BXSYGJ/PaceRV/materials/README.md

# 竞赛作品材料

- `PaceRV_作品技术报告.pdf`：完整作品技术报告，21 页。
- `PaceRV_嵌赛FPGA_三分钟讲解.pptx`：15 页讲解 PPT。
- `PaceRV_三分钟逐页讲解稿.md`：逐页口播与排练安排。
- `PaceRV_作品海报.pdf`：A1 作品海报。
- `PaceRV_作品海报_高清.png`：10,000 × 14,158 像素高清海报。
- `editable/`：Word 报告与可编辑 SVG 海报。

所有材料使用盘古 100Pro+ 板卡表述。工程源码和烧录说明分别见 `../hardware/` 与 `../hardware/docs/BUILD_AND_RUN.md`。大幅面海报可直接下载；GitHub 在线预览使用首页的小尺寸版本。
