BXSYGJ/PaceRV/materials/PaceRV_三分钟逐页讲解稿.md

# PaceRV 三分钟逐页讲解稿

对应当前 15 页 PPT。排练预算为 180 秒，其中第 14 页包含 12 秒实景片段，口播预算合计 168 秒。时间是剪辑与排练分配，实际时长以录音为准。

每页的正文可以直接朗读；“讲法”用于排练，不进入口播。性能精确值留在画面上，口播按稿内精度表达。

## 第 1 页｜PaceRV · 作品开场｜00:00–00:07

这是 PaceRV：执行效率达到同类 SOTA 水平的五级自研软核。

讲法：PaceRV 后稍停；重读“同类 SOTA 水平”。首页不念性能数字。

## 第 2 页｜赛题成果｜00:07–00:17

我们从完整指令集、五级流水线做到缓存、预测与中断，再拓展音频智能计算，把基础内核做成可集成的计算平台。

讲法：前半句随左右两栏扫过，落点放在“可集成的计算平台”。

## 第 3 页｜国际学术交流｜00:17–00:24

PaceRV 的架构研究已获 IEEE MCSoC 正式论文录用，走向国际学术交流平台。

讲法：会议名称读清楚，不朗读会议截图中的长段介绍。

## 第 4 页｜论文成果｜00:24–00:38

论文抓住了一个关键问题：存储请求何时被接纳，会怎样改变预备乘法结果的保留需求？我们把流水线优化，推进到可量化、可预测的架构研究，全文已公开于 arXiv。

讲法：问题句后稍停；重读“可量化、可预测”。网址留在画面上。

## 第 5 页｜开源成果｜00:38–00:46

源码、构建工程和测试证据已经开源。PaceRV 既能复现，也能成为下一项设计的起点。

讲法：两句之间稍停，GitHub 地址让观众看，不逐字符读。

## 第 6 页｜系统架构｜00:46–00:59

系统由自研处理器调度，音频特征和神经网络交给专用硬件计算。从采集、特征提取到八类结果显示，控制与计算各司其职。

讲法：顺着图从左向右讲，最后回到处理器与专用计算的分工。

## 第 7 页｜CPU 协同优化｜00:59–01:19

我们的优化抓住三个动作：供给不断流，访存早接纳，结果少重算。压缩前端与分支预测维持指令供给；提前接纳请求缓解存储争用；预备乘法按指令身份复用结果，把等待转成有效计算。

讲法：三个动作逐个落音，再用图解释。结尾“把等待转成有效计算”放慢。

## 第 8 页｜主力版本 · Original｜01:19–01:33

这些设计落到了真实板卡上。主力版本跑出五百二十二点五三 CoreMark，频率一百五十五点二五兆赫，完整系统约六千 LUT。高吞吐，也有紧凑实现。

讲法：CoreMark、频率、资源三个信息分开落音。522.531 口播保留两位小数，精确值由页面呈现。

## 第 9 页｜同类 SOTA 执行效率 · H3 Base｜01:33–01:44

衡量架构效率，要看每一兆赫完成多少工作。H3 Base 达到三点四四二，比匹配 VexRiscv 高百分之二十五点五。

讲法：先解释每兆赫指标，再念结果。重读“三点四四二”和“百分之二十五点五”。

## 第 10 页｜性能对照｜01:44–01:52

主力版追求总吞吐，H3 Base 追求每兆赫效率。两种优化点，共同体现架构的可调空间。

讲法：表格让观众看；口播解释两版定位，不逐格报数。

## 第 11 页｜裸核与系统集成｜01:52–02:00

完整 CPU 裸核约四千 LUT，保留运算单元、预测器和寄存器堆，让高性能内核更容易集成。

讲法：重读“完整 CPU 裸核”和“约四千 LUT”。不把折算效率说成新一次裸核板测。

## 第 12 页｜音频与特征提取｜02:00–02:15

现在把计算能力用到声音上。真实采集和重采样已经上板。硬件进一步提取六十四频带特征；按仿真周期折算到一百二十五兆赫，单窗口约四十一点二毫秒。

讲法：第一句完成 CPU 到应用的转场。上板采集与仿真折算各自说清，实物图不遮挡。

## 第 13 页｜神经网络加速｜02:15–02:32

四层卷积，复用十六路八位整数乘加阵列，输出八类乐器结果。按同一频率折算，单轮推理约二百四十九毫秒；两轮连续输入，各层结果均与定点参考逐值一致。

讲法：重读“四层复用”和“逐值一致”。同一频率承接上一页的 125 MHz，画面保留 249.1 ms 精确值。

## 第 14 页｜中文可视化与实景片段｜02:32–02:52

输入波形、梅尔频谱、八类结果，同屏呈现。接下来，请看实物连接与实屏回放。

讲法：约 8 秒口播后留 12 秒实景：整体连接、主板与音频模块、中文实屏回放。保留画面中的回放标识。

## 第 15 页｜PaceRV · 自主计算｜02:52–03:00

从自主内核到专用计算，从论文录用到代码开源。PaceRV，让国产 FPGA 听见更多。

讲法：PaceRV 前稍停，最后一句放慢收住。

## 录制要点

把它当成向评委介绍一件做成的作品。开头落稳，架构页顺图解释，性能页在数字后稍停。重音放在成果、动作和结果上。

SOTA 可读作“搜塔”；CoreMark、LUT、MCSoC、VexRiscv 等名称在录制前统一读法，英文名称也要计入实际口播时间。RV32IMC 和网页地址可由画面承载。

先连贯录一遍，再按实录时长调整各页停留。第 7 页留给机制解释，第 8、9 页留给性能数字。第 3、5、10 页保持简洁。第 14 页为 8 秒讲解和 12 秒实景，实景结束后进入收尾。

这份稿件重新分配了逐页时间，PPT 页面内容保持原样。剪辑按本稿时间表安排。

## 本次写法参考

- [昆士兰大学 3MT 参赛指南](https://threeminutethesis.uq.edu.au/resources/3mt-competitor-guide)：面向听众，用起承转合串起问题、结果与意义，并通过朗读修改。
- [昆士兰大学 3MT 评审标准](https://threeminutethesis.uq.edu.au/resources/judging-criteria-and-panel)：让听众理解动机、设计和结果，图像服务表达。
- [TEDx 演讲准备指南](https://www.ted.com/tedx/organizer-guide/prepare-speakers-and-program)：围绕一个主张安排结构，控制长度，采用自然交谈语气，并反复排练。

以上用于借鉴短讲写法；本视频沿用已有 15 页结构。
