BXSYGJ/PaceRV/materials/photos/100ProPlus开发板.png

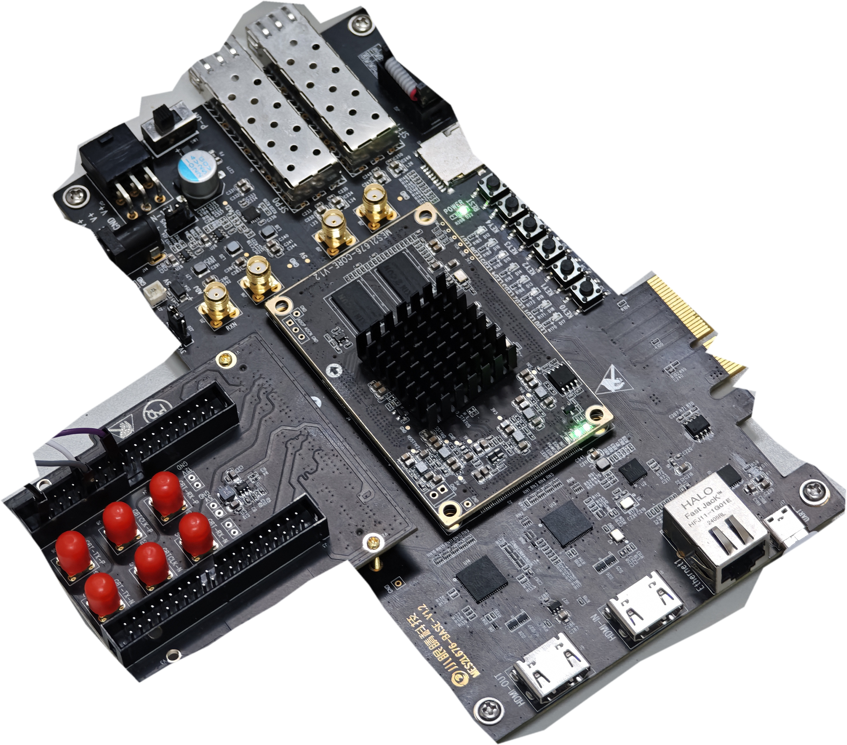
materials/photos/100ProPlus开发板.png
