BXSYGJ/PaceRV/materials/photos/完整系统.jpg

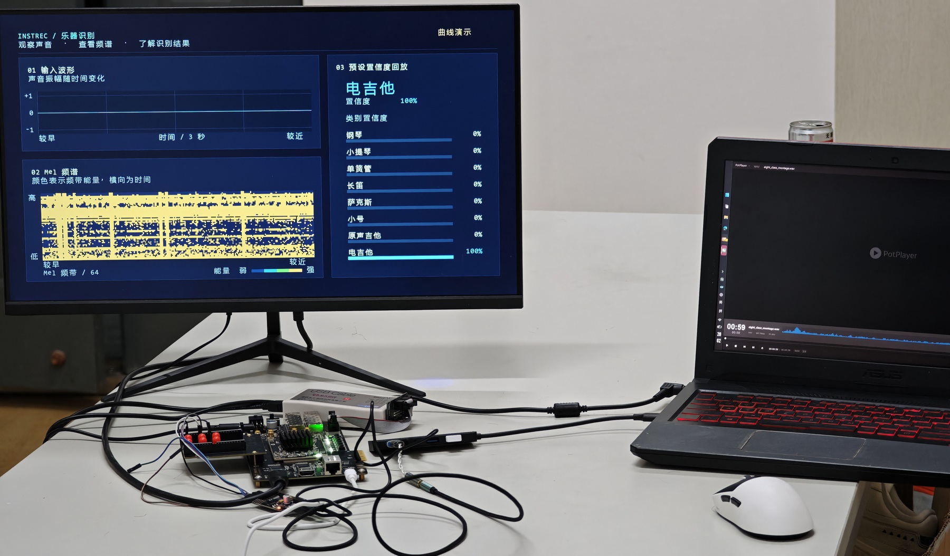
materials/photos/完整系统.jpg
