BXSYGJ/PaceRV/materials/waveforms/H3_Base_145125/analysis/core_bench_matrix/trigger-zoom.png

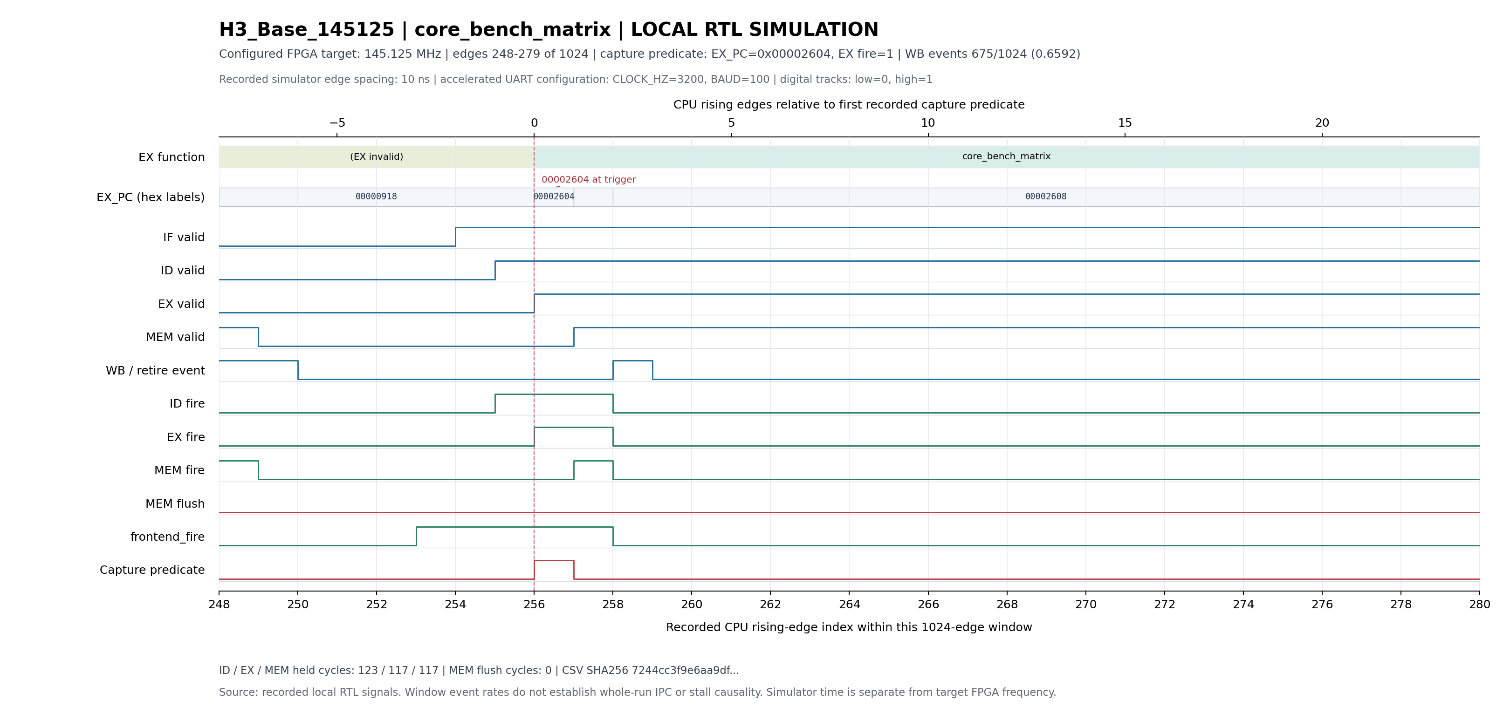
materials/waveforms/H3_Base_145125/analysis/core_bench_matrix/trigger-zoom.png
