BXSYGJ/PaceRV/materials/waveforms/H3_Base_145125/analysis/core_bench_state/full1024.png

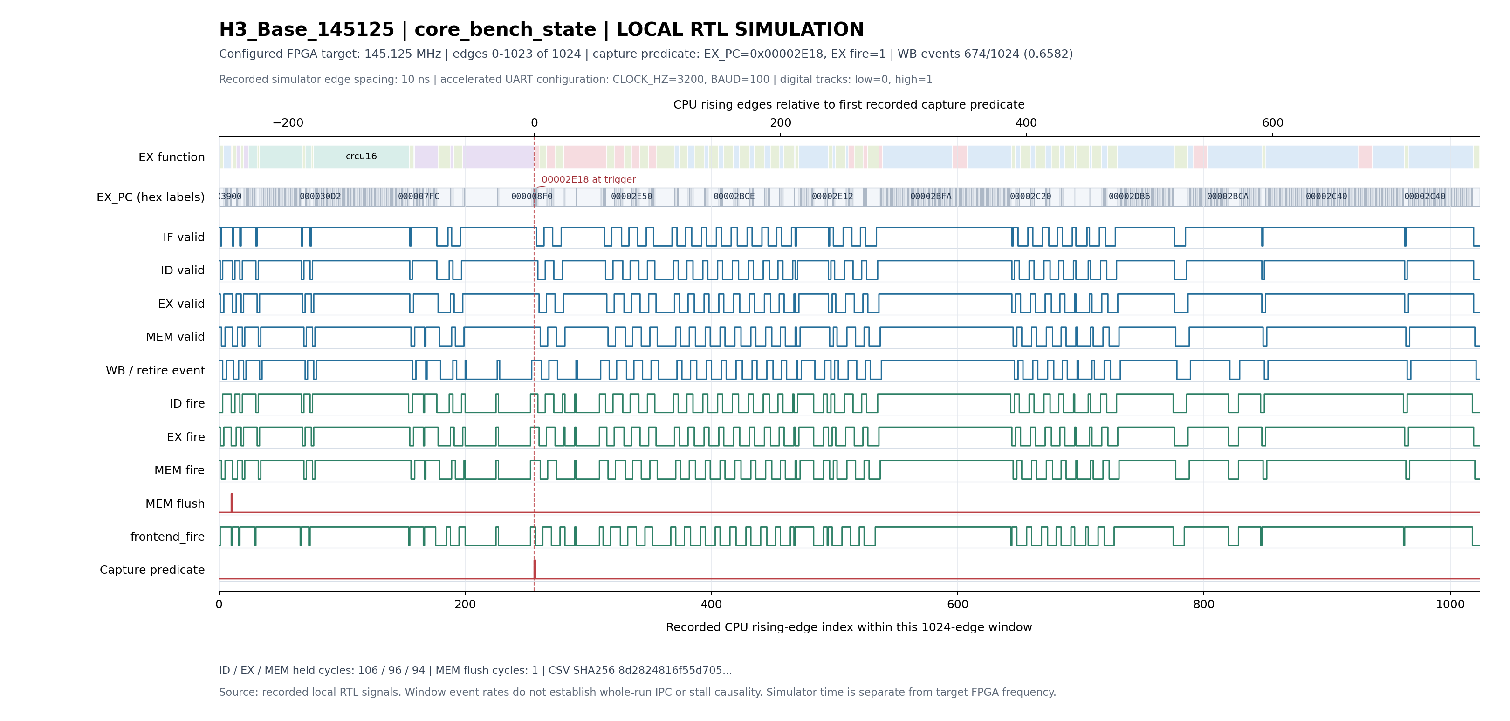
materials/waveforms/H3_Base_145125/analysis/core_bench_state/full1024.png
