BXSYGJ/PaceRV/materials/waveforms/H3_Base_145125/analysis/core_bench_state/trigger-zoom.png

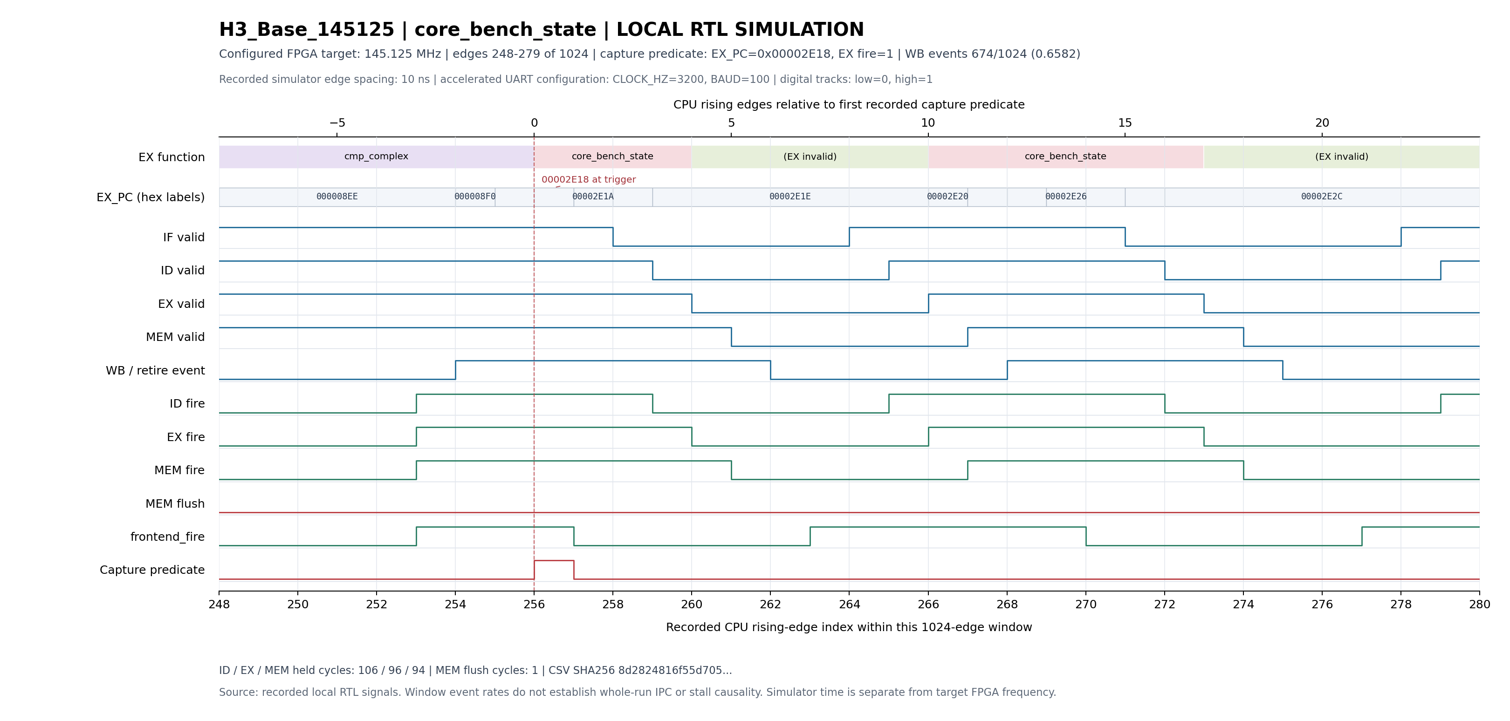
materials/waveforms/H3_Base_145125/analysis/core_bench_state/trigger-zoom.png
