BXSYGJ/PaceRV/materials/waveforms/Original_155250/analysis/core_bench_list/trigger-zoom.png

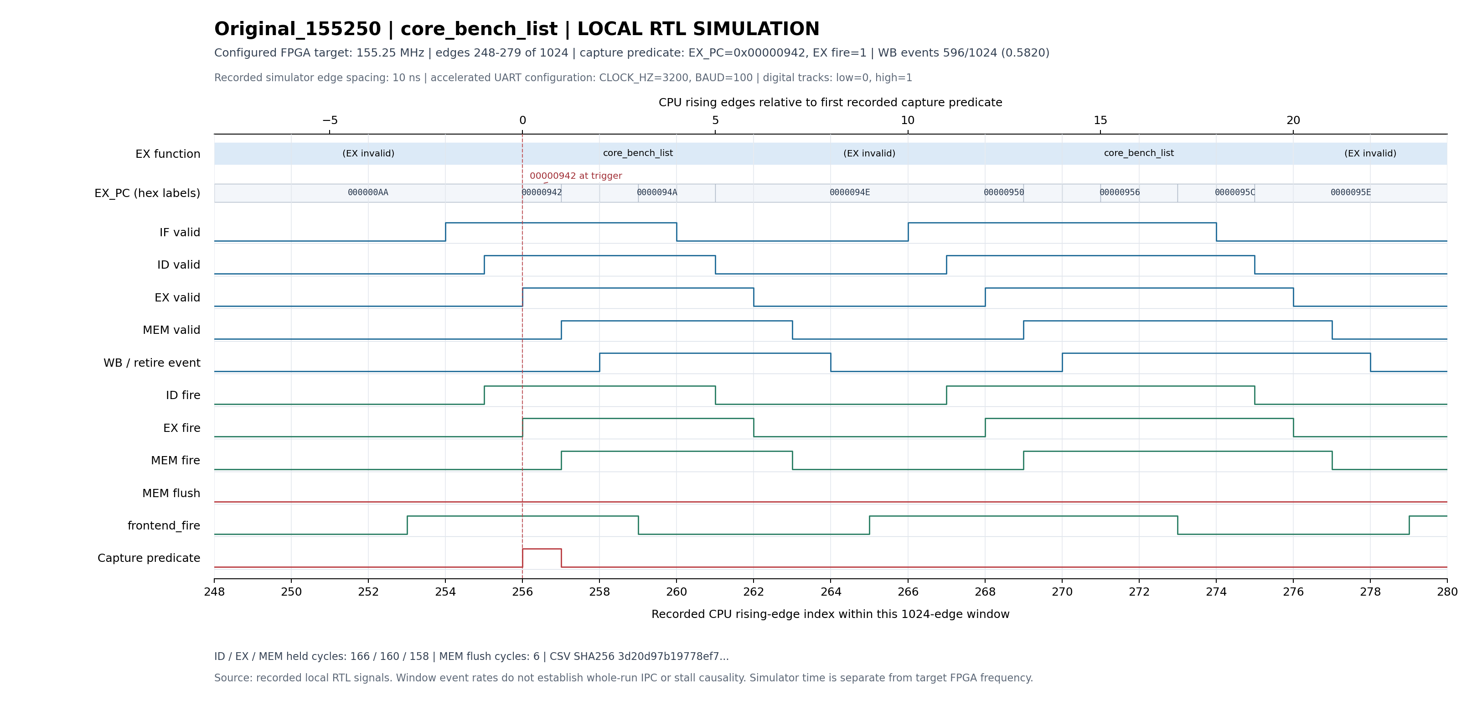
materials/waveforms/Original_155250/analysis/core_bench_list/trigger-zoom.png
