BXSYGJ/PaceRV/materials/waveforms/Original_155250/analysis/core_bench_matrix/full1024.png

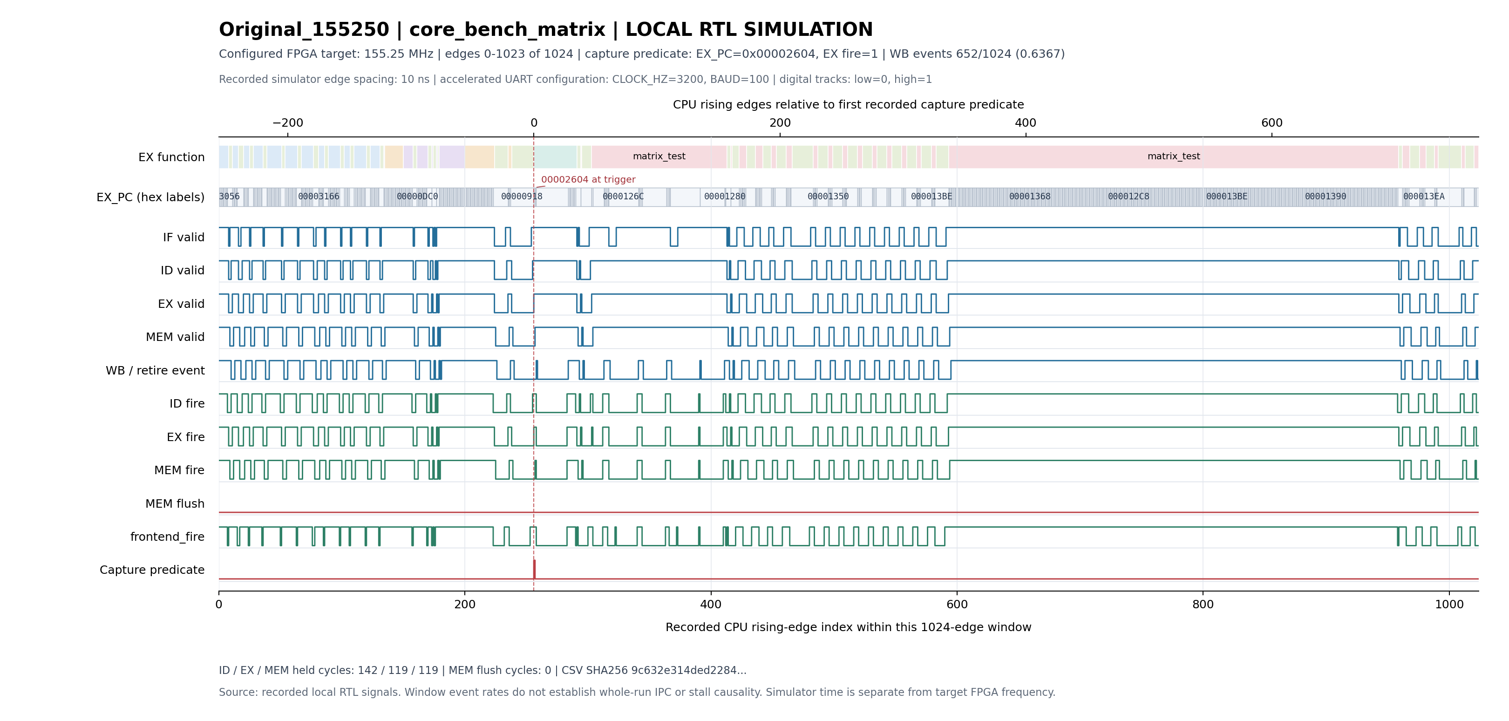
materials/waveforms/Original_155250/analysis/core_bench_matrix/full1024.png
