BXSYGJ/PaceRV/materials/waveforms/Original_155250/analysis/core_bench_state/trigger-zoom.png

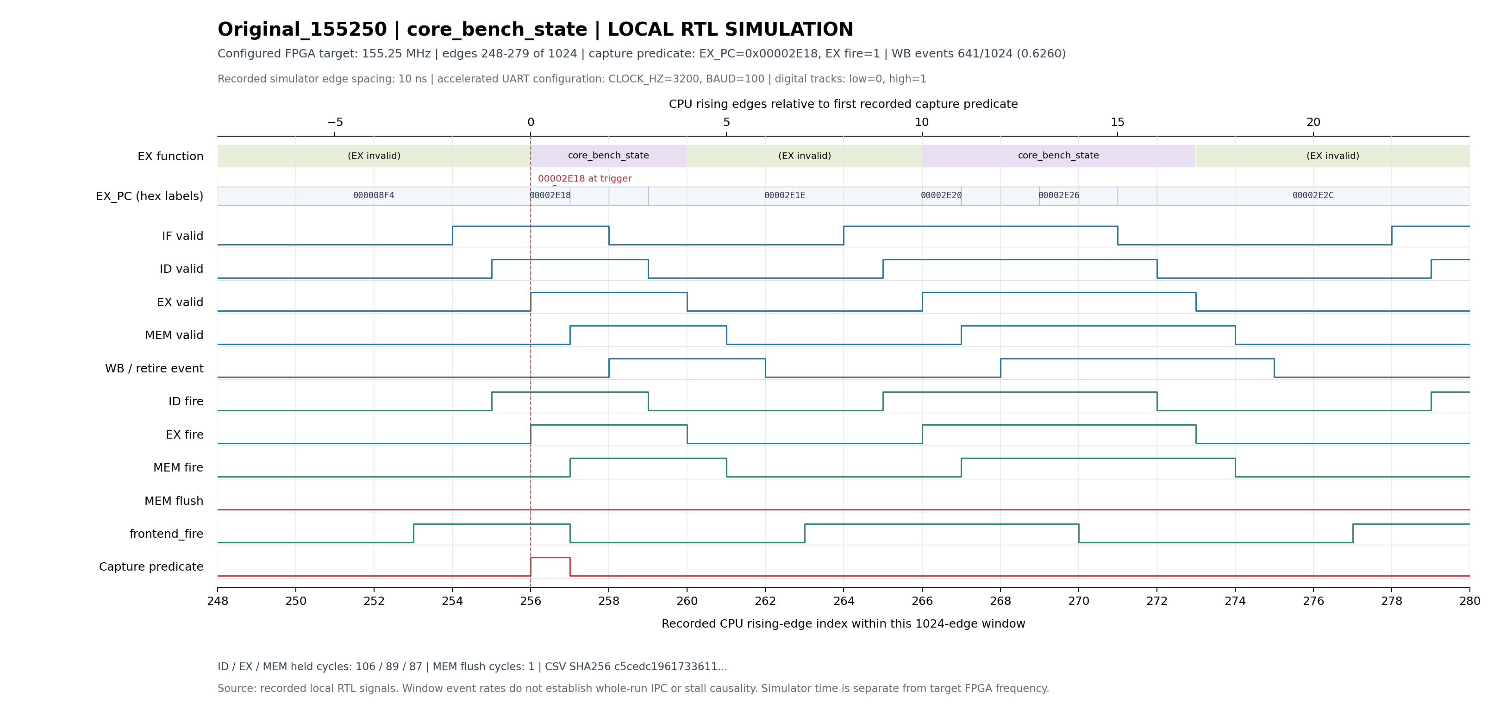
materials/waveforms/Original_155250/analysis/core_bench_state/trigger-zoom.png
