BXSYGJ/PaceRV/materials/PaceRV_作品海报.pdf

## FPGA 创新设计赛道

# PaceRV

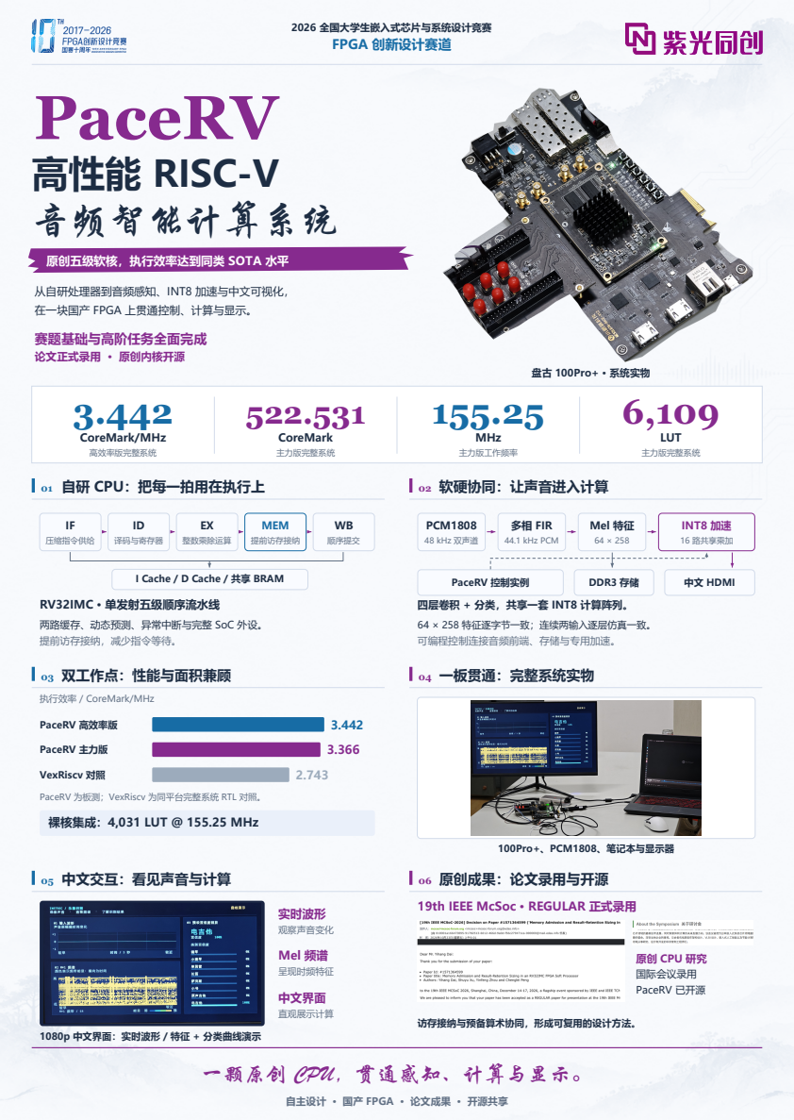
[picture p39: page 1]
2026 全国大学生嵌入式芯片与系统设计竞赛; 高性能 RISC-V 音频智能计算系统; 盘古 100Pro+ · 系统实物; CoreMark/MHz; 高效率版完整系统; CoreMark; 主力版完整系统; MHz; 主力版工作频率; LUT; 01 自研 CPU：把每一拍用在执行上; 02 软硬协同：让声音进入计算; 压缩指令供给; 译码与寄存器; 整数乘除运算; MEM; 提前访存接纳; 顺序提交; PCM1808; 48 kHz 双声道; 多相 FIR; 44.1 kHz PCM; Mel 特征; INT8 加速; 16 路共享乘加; PaceRV 控制实例; DDR3 存储; 中文 HDMI; 03 双工作点：性能与面积兼顾; 04 一板贯通：完整系统实物; PaceRV 高效率版; PaceRV 主力版; VexRiscv 对照; 100Pro+、PCM1808、笔记本与显示器; 05 中文交互：看见声音与计算; 06 原创成果：论文录用与开源; 实时波形; 观察声音变化; Mel 频谱; 呈现时频特征; 中文界面; 直观展示计算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

原创五级软核，执行效率达到同类 SOTA 水平

从自研处理器到音频感知、INT8 加速与中文可视化，
在一块国产 FPGA 上贯通控制、计算与显示。
赛题基础与高阶任务全面完成
论文正式录用 · 原创内核开源

I Cache / D Cache / 共享 BRAM

RV32IMC · 单发射五级顺序流水线
两路缓存、动态预测、异常中断与完整 SoC 外设。
提前访存接纳，减少指令等待。

四层卷积 + 分类，共享一套 INT8 计算阵列。
64 × 258 特征逐字节一致；连续两输入逐层仿真一致。
可编程控制连接音频前端、存储与专用加速。

执行效率 / CoreMark/MHz

PaceRV 为板测；VexRiscv 为同平台完整系统 RTL 对照。

裸核集成：4,031 LUT @ 155.25 MHz

19th IEEE McSoc · REGULAR 正式录用

原创 CPU 研究
国际会议录用
PaceRV 已开源

1080p 中文界面：实时波形 / 特征 + 分类曲线演示

一颗原创 CPU，贯通感知、计算与显示。

自主设计 · 国产 FPGA · 论文成果 · 开源共享
