BXSYGJ/PaceRV/hardware/code/system_application/src/audio/pcm1808_coeff_rom.v

module pcm1808_coeff_rom (
    input wire clk, input wire [7:0] phase, input wire [6:0] tap,
    output wire signed [15:0] coeff
);
    wire mirrored = phase > 8'd73;
    wire [7:0] base_phase = mirrored ? 8'd147 - phase : phase;
    wire [6:0] base_tap = mirrored ? 7'd95 - tap : tap;
    wire [12:0] addr = base_phase * 13'd96 + base_tap;
    reg signed [15:0] base_coeff;
    reg signed [4:0] correction, correction_pipe;
    assign coeff = base_coeff + {{11{correction_pipe[4]}}, correction_pipe};
    always @* begin
        correction = 5'sd0;
        case (phase)
            8'd74: correction = 5'h00;
            8'd75: correction = 5'h19;
            8'd76: correction = 5'h06;
            8'd77: correction = 5'h02;
            8'd78: correction = 5'h1e;
            8'd79: correction = 5'h1f;
            8'd80: correction = 5'h1f;
            8'd81: correction = 5'h03;
            8'd82: correction = 5'h1c;
            8'd83: correction = 5'h04;
            8'd84: correction = 5'h1e;
            8'd85: correction = 5'h1d;
            8'd86: correction = 5'h00;
            8'd87: correction = 5'h1e;
            8'd88: correction = 5'h04;
            8'd89: correction = 5'h00;
            8'd90: correction = 5'h1d;
            8'd91: correction = 5'h02;
            8'd92: correction = 5'h02;
            8'd93: correction = 5'h01;
            8'd94: correction = 5'h06;
            8'd95: correction = 5'h01;
            8'd96: correction = 5'h04;
            8'd97: correction = 5'h1e;
            8'd98: correction = 5'h00;
            8'd99: correction = 5'h04;
            8'd100: correction = 5'h03;
            8'd101: correction = 5'h1f;
            8'd102: correction = 5'h05;
            8'd103: correction = 5'h03;
            8'd104: correction = 5'h02;
            8'd105: correction = 5'h1a;
            8'd106: correction = 5'h01;
            8'd107: correction = 5'h04;
            8'd108: correction = 5'h1f;
            8'd109: correction = 5'h1f;
            8'd110: correction = 5'h1d;
            8'd111: correction = 5'h00;
            8'd112: correction = 5'h1f;
            8'd113: correction = 5'h04;
            8'd114: correction = 5'h03;
            8'd115: correction = 5'h02;
            8'd116: correction = 5'h01;
            8'd117: correction = 5'h01;
            8'd118: correction = 5'h1f;
            8'd119: correction = 5'h1f;
            8'd120: correction = 5'h00;
            8'd121: correction = 5'h1e;
            8'd122: correction = 5'h00;
            8'd123: correction = 5'h1e;
            8'd124: correction = 5'h1d;
            8'd125: correction = 5'h00;
            8'd126: correction = 5'h1f;
            8'd127: correction = 5'h1c;
            8'd128: correction = 5'h1e;
            8'd129: correction = 5'h1d;
            8'd130: correction = 5'h1f;
            8'd131: correction = 5'h1f;
            8'd132: correction = 5'h03;
            8'd133: correction = 5'h1e;
            8'd134: correction = 5'h1e;
            8'd135: correction = 5'h1b;
            8'd136: correction = 5'h02;
            8'd137: correction = 5'h1c;
            8'd138: correction = 5'h01;
            8'd139: correction = 5'h1f;
            8'd140: correction = 5'h03;
            8'd141: correction = 5'h02;
            8'd142: correction = 5'h04;
            8'd143: correction = 5'h01;
            8'd144: correction = 5'h02;
            8'd145: correction = 5'h1c;
            8'd146: correction = 5'h01;
            default: correction = 5'sd0;
        endcase
    end
    always @(posedge clk) begin
        if (mirrored && tap == 7'd47) correction_pipe <= correction;
        else if (mirrored && tap == 7'd48) correction_pipe <= -correction;
        else correction_pipe <= 5'sd0;
        case (addr)
            13'd0: base_coeff <= 16'h0001;
            13'd1: base_coeff <= 16'hfffe;
            13'd2: base_coeff <= 16'h0003;
            13'd3: base_coeff <= 16'hfffc;
            13'd4: base_coeff <= 16'h0004;
            13'd5: base_coeff <= 16'hfffd;
            13'd6: base_coeff <= 16'hffff;
            13'd7: base_coeff <= 16'h0006;
            13'd8: base_coeff <= 16'hfff3;
            13'd9: base_coeff <= 16'h0013;
            13'd10: base_coeff <= 16'hffea;
            13'd11: base_coeff <= 16'h0014;
            13'd12: base_coeff <= 16'hfff5;
            13'd13: base_coeff <= 16'hfffb;
            13'd14: base_coeff <= 16'h001b;
            13'd15: base_coeff <= 16'hffcf;
            13'd16: base_coeff <= 16'h0042;
            13'd17: base_coeff <= 16'hffb9;
            13'd18: base_coeff <= 16'h003a;
            13'd19: base_coeff <= 16'hffe6;
            13'd20: base_coeff <= 16'hffe9;
            13'd21: base_coeff <= 16'h0051;
            13'd22: base_coeff <= 16'hff78;
            13'd23: base_coeff <= 16'h00ac;
            13'd24: base_coeff <= 16'hff52;
            13'd25: base_coeff <= 16'h0085;
            13'd26: base_coeff <= 16'hffd0;
            13'd27: base_coeff <= 16'hffb8;
            13'd28: base_coeff <= 16'h00cd;
            13'd29: base_coeff <= 16'hfebe;
            13'd30: base_coeff <= 16'h0186;
            13'd31: base_coeff <= 16'hfe85;
            13'd32: base_coeff <= 16'h0111;
            13'd33: base_coeff <= 16'hffb8;
            13'd34: base_coeff <= 16'hff39;
            13'd35: base_coeff <= 16'h01ed;
            13'd36: base_coeff <= 16'hfd16;
            13'd37: base_coeff <= 16'h0377;
            13'd38: base_coeff <= 16'hfcad;
            13'd39: base_coeff <= 16'h024f;
            13'd40: base_coeff <= 16'hffa6;
            13'd41: base_coeff <= 16'hfd8a;
            13'd42: base_coeff <= 16'h05e6;
            13'd43: base_coeff <= 16'hf666;
            13'd44: base_coeff <= 16'h0d24;
            13'd45: base_coeff <= 16'heff0;
            13'd46: base_coeff <= 16'h11fe;
            13'd47: base_coeff <= 16'h6d54;
            13'd48: base_coeff <= 16'h11fe;
            13'd49: base_coeff <= 16'heff0;
            13'd50: base_coeff <= 16'h0d24;
            13'd51: base_coeff <= 16'hf666;
            13'd52: base_coeff <= 16'h05e6;
            13'd53: base_coeff <= 16'hfd8a;
            13'd54: base_coeff <= 16'hffa6;
            13'd55: base_coeff <= 16'h024f;
            13'd56: base_coeff <= 16'hfcad;
            13'd57: base_coeff <= 16'h0377;
            13'd58: base_coeff <= 16'hfd16;
            13'd59: base_coeff <= 16'h01ed;
            13'd60: base_coeff <= 16'hff39;
            13'd61: base_coeff <= 16'hffb8;
            13'd62: base_coeff <= 16'h0111;
            13'd63: base_coeff <= 16'hfe85;
            13'd64: base_coeff <= 16'h0186;
            13'd65: base_coeff <= 16'hfebe;
            13'd66: base_coeff <= 16'h00cd;
            13'd67: base_coeff <= 16'hffb8;
            13'd68: base_coeff <= 16'hffd0;
            13'd69: base_coeff <= 16'h0085;
            13'd70: base_coeff <= 16'hff52;
            13'd71: base_coeff <= 16'h00ac;
            13'd72: base_coeff <= 16'hff78;
            13'd73: base_coeff <= 16'h0051;
            13'd74: base_coeff <= 16'hffe9;
            13'd75: base_coeff <= 16'hffe6;
            13'd76: base_coeff <= 16'h003a;
            13'd77: base_coeff <= 16'hffb9;
            13'd78: base_coeff <= 16'h0042;
            13'd79: base_coeff <= 16'hffcf;
            13'd80: base_coeff <= 16'h001b;
            13'd81: base_coeff <= 16'hfffb;
            13'd82: base_coeff <= 16'hfff5;
            13'd83: base_coeff <= 16'h0014;
            13'd84: base_coeff <= 16'hffea;
            13'd85: base_coeff <= 16'h0013;
            13'd86: base_coeff <= 16'hfff3;
            13'd87: base_coeff <= 16'h0006;
            13'd88: base_coeff <= 16'hffff;
            13'd89: base_coeff <= 16'hfffd;
            13'd90: base_coeff <= 16'h0004;
            13'd91: base_coeff <= 16'hfffc;
            13'd92: base_coeff <= 16'h0003;
            13'd93: base_coeff <= 16'hfffe;
            13'd94: base_coeff <= 16'h0001;
            13'd95: base_coeff <= 16'h0000;
            13'd96: base_coeff <= 16'h0001;
            13'd97: base_coeff <= 16'hfffe;
            13'd98: base_coeff <= 16'h0003;
            13'd99: base_coeff <= 16'hfffc;
            13'd100: base_coeff <= 16'h0004;
            13'd101: base_coeff <= 16'hfffd;
            13'd102: base_coeff <= 16'hffff;
            13'd103: base_coeff <= 16'h0006;
            13'd104: base_coeff <= 16'hfff3;
            13'd105: base_coeff <= 16'h0013;
            13'd106: base_coeff <= 16'hffea;
            13'd107: base_coeff <= 16'h0014;
            13'd108: base_coeff <= 16'hfff6;
            13'd109: base_coeff <= 16'hfffa;
            13'd110: base_coeff <= 16'h001b;
            13'd111: base_coeff <= 16'hffcf;
            13'd112: base_coeff <= 16'h0042;
            13'd113: base_coeff <= 16'hffba;
            13'd114: base_coeff <= 16'h0039;
            13'd115: base_coeff <= 16'hffe8;
            13'd116: base_coeff <= 16'hffe7;
            13'd117: base_coeff <= 16'h0053;
            13'd118: base_coeff <= 16'hff77;
            13'd119: base_coeff <= 16'h00ab;
            13'd120: base_coeff <= 16'hff54;
            13'd121: base_coeff <= 16'h0082;
            13'd122: base_coeff <= 16'hffd4;
            13'd123: base_coeff <= 16'hffb3;
            13'd124: base_coeff <= 16'h00d1;
            13'd125: base_coeff <= 16'hfebc;
            13'd126: base_coeff <= 16'h0185;
            13'd127: base_coeff <= 16'hfe89;
            13'd128: base_coeff <= 16'h0109;
            13'd129: base_coeff <= 16'hffc2;
            13'd130: base_coeff <= 16'hff2f;
            13'd131: base_coeff <= 16'h01f5;
            13'd132: base_coeff <= 16'hfd12;
            13'd133: base_coeff <= 16'h0374;
            13'd134: base_coeff <= 16'hfcb8;
            13'd135: base_coeff <= 16'h023c;
            13'd136: base_coeff <= 16'hffbf;
            13'd137: base_coeff <= 16'hfd6f;
            13'd138: base_coeff <= 16'h05fc;
            13'd139: base_coeff <= 16'hf65e;
            13'd140: base_coeff <= 16'h0d0f;
            13'd141: base_coeff <= 16'hf038;
            13'd142: base_coeff <= 16'h1135;
            13'd143: base_coeff <= 16'h6d55;
            13'd144: base_coeff <= 16'h12c9;
            13'd145: base_coeff <= 16'hefa8;
            13'd146: base_coeff <= 16'h0d37;
            13'd147: base_coeff <= 16'hf66e;
            13'd148: base_coeff <= 16'h05d0;
            13'd149: base_coeff <= 16'hfda5;
            13'd150: base_coeff <= 16'hff8c;
            13'd151: base_coeff <= 16'h0263;
            13'd152: base_coeff <= 16'hfca1;
            13'd153: base_coeff <= 16'h037a;
            13'd154: base_coeff <= 16'hfd1a;
            13'd155: base_coeff <= 16'h01e4;
            13'd156: base_coeff <= 16'hff44;
            13'd157: base_coeff <= 16'hffae;
            13'd158: base_coeff <= 16'h0118;
            13'd159: base_coeff <= 16'hfe81;
            13'd160: base_coeff <= 16'h0187;
            13'd161: base_coeff <= 16'hfec0;
            13'd162: base_coeff <= 16'h00c9;
            13'd163: base_coeff <= 16'hffbd;
            13'd164: base_coeff <= 16'hffcb;
            13'd165: base_coeff <= 16'h0089;
            13'd166: base_coeff <= 16'hff50;
            13'd167: base_coeff <= 16'h00ac;
            13'd168: base_coeff <= 16'hff7a;
            13'd169: base_coeff <= 16'h004f;
            13'd170: base_coeff <= 16'hffeb;
            13'd171: base_coeff <= 16'hffe4;
            13'd172: base_coeff <= 16'h003b;
            13'd173: base_coeff <= 16'hffb9;
            13'd174: base_coeff <= 16'h0042;
            13'd175: base_coeff <= 16'hffd0;
            13'd176: base_coeff <= 16'h001a;
            13'd177: base_coeff <= 16'hfffb;
            13'd178: base_coeff <= 16'hfff4;
            13'd179: base_coeff <= 16'h0014;
            13'd180: base_coeff <= 16'hffea;
            13'd181: base_coeff <= 16'h0013;
            13'd182: base_coeff <= 16'hfff3;
            13'd183: base_coeff <= 16'h0006;
            13'd184: base_coeff <= 16'h0000;
            13'd185: base_coeff <= 16'hfffd;
            13'd186: base_coeff <= 16'h0004;
            13'd187: base_coeff <= 16'hfffc;
            13'd188: base_coeff <= 16'h0003;
            13'd189: base_coeff <= 16'hfffe;
            13'd190: base_coeff <= 16'h0001;
            13'd191: base_coeff <= 16'h0000;
            13'd192: base_coeff <= 16'h0001;
            13'd193: base_coeff <= 16'hfffe;
            13'd194: base_coeff <= 16'h0003;
            13'd195: base_coeff <= 16'hfffc;
            13'd196: base_coeff <= 16'h0004;
            13'd197: base_coeff <= 16'hfffd;
            13'd198: base_coeff <= 16'hffff;
            13'd199: base_coeff <= 16'h0007;
            13'd200: base_coeff <= 16'hfff3;
            13'd201: base_coeff <= 16'h0013;
            13'd202: base_coeff <= 16'hffea;
            13'd203: base_coeff <= 16'h0013;
            13'd204: base_coeff <= 16'hfff6;
            13'd205: base_coeff <= 16'hfff9;
            13'd206: base_coeff <= 16'h001c;
            13'd207: base_coeff <= 16'hffce;
            13'd208: base_coeff <= 16'h0042;
            13'd209: base_coeff <= 16'hffbb;
            13'd210: base_coeff <= 16'h0038;
            13'd211: base_coeff <= 16'hffe9;
            13'd212: base_coeff <= 16'hffe5;
            13'd213: base_coeff <= 16'h0055;
            13'd214: base_coeff <= 16'hff76;
            13'd215: base_coeff <= 16'h00ab;
            13'd216: base_coeff <= 16'hff56;
            13'd217: base_coeff <= 16'h007f;
            13'd218: base_coeff <= 16'hffd9;
            13'd219: base_coeff <= 16'hffaf;
            13'd220: base_coeff <= 16'h00d5;
            13'd221: base_coeff <= 16'hfeba;
            13'd222: base_coeff <= 16'h0184;
            13'd223: base_coeff <= 16'hfe8e;
            13'd224: base_coeff <= 16'h0101;
            13'd225: base_coeff <= 16'hffcc;
            13'd226: base_coeff <= 16'hff24;
            13'd227: base_coeff <= 16'h01fd;
            13'd228: base_coeff <= 16'hfd0f;
            13'd229: base_coeff <= 16'h0371;
            13'd230: base_coeff <= 16'hfcc3;
            13'd231: base_coeff <= 16'h0228;
            13'd232: base_coeff <= 16'hffd8;
            13'd233: base_coeff <= 16'hfd55;
            13'd234: base_coeff <= 16'h0611;
            13'd235: base_coeff <= 16'hf658;
            13'd236: base_coeff <= 16'h0cfa;
            13'd237: base_coeff <= 16'hf081;
            13'd238: base_coeff <= 16'h106d;
            13'd239: base_coeff <= 16'h6d4b;
            13'd240: base_coeff <= 16'h1394;
            13'd241: base_coeff <= 16'hef62;
            13'd242: base_coeff <= 16'h0d4a;
            13'd243: base_coeff <= 16'hf677;
            13'd244: base_coeff <= 16'h05b9;
            13'd245: base_coeff <= 16'hfdc1;
            13'd246: base_coeff <= 16'hff73;
            13'd247: base_coeff <= 16'h0276;
            13'd248: base_coeff <= 16'hfc97;
            13'd249: base_coeff <= 16'h037d;
            13'd250: base_coeff <= 16'hfd1f;
            13'd251: base_coeff <= 16'h01db;
            13'd252: base_coeff <= 16'hff4e;
            13'd253: base_coeff <= 16'hffa4;
            13'd254: base_coeff <= 16'h0120;
            13'd255: base_coeff <= 16'hfe7d;
            13'd256: base_coeff <= 16'h0187;
            13'd257: base_coeff <= 16'hfec2;
            13'd258: base_coeff <= 16'h00c5;
            13'd259: base_coeff <= 16'hffc2;
            13'd260: base_coeff <= 16'hffc7;
            13'd261: base_coeff <= 16'h008c;
            13'd262: base_coeff <= 16'hff4f;
            13'd263: base_coeff <= 16'h00ac;
            13'd264: base_coeff <= 16'hff7b;
            13'd265: base_coeff <= 16'h004d;
            13'd266: base_coeff <= 16'hffed;
            13'd267: base_coeff <= 16'hffe2;
            13'd268: base_coeff <= 16'h003d;
            13'd269: base_coeff <= 16'hffb8;
            13'd270: base_coeff <= 16'h0042;
            13'd271: base_coeff <= 16'hffd0;
            13'd272: base_coeff <= 16'h0019;
            13'd273: base_coeff <= 16'hfffc;
            13'd274: base_coeff <= 16'hfff4;
            13'd275: base_coeff <= 16'h0015;
            13'd276: base_coeff <= 16'hffe9;
            13'd277: base_coeff <= 16'h0013;
            13'd278: base_coeff <= 16'hfff3;
            13'd279: base_coeff <= 16'h0006;
            13'd280: base_coeff <= 16'h0000;
            13'd281: base_coeff <= 16'hfffd;
            13'd282: base_coeff <= 16'h0005;
            13'd283: base_coeff <= 16'hfffc;
            13'd284: base_coeff <= 16'h0003;
            13'd285: base_coeff <= 16'hfffe;
            13'd286: base_coeff <= 16'h0001;
            13'd287: base_coeff <= 16'h0000;
            13'd288: base_coeff <= 16'h0001;
            13'd289: base_coeff <= 16'hfffe;
            13'd290: base_coeff <= 16'h0003;
            13'd291: base_coeff <= 16'hfffc;
            13'd292: base_coeff <= 16'h0004;
            13'd293: base_coeff <= 16'hfffd;
            13'd294: base_coeff <= 16'hffff;
            13'd295: base_coeff <= 16'h0007;
            13'd296: base_coeff <= 16'hfff3;
            13'd297: base_coeff <= 16'h0013;
            13'd298: base_coeff <= 16'hffea;
            13'd299: base_coeff <= 16'h0013;
            13'd300: base_coeff <= 16'hfff7;
            13'd301: base_coeff <= 16'hfff9;
            13'd302: base_coeff <= 16'h001d;
            13'd303: base_coeff <= 16'hffce;
            13'd304: base_coeff <= 16'h0042;
            13'd305: base_coeff <= 16'hffbb;
            13'd306: base_coeff <= 16'h0036;
            13'd307: base_coeff <= 16'hffeb;
            13'd308: base_coeff <= 16'hffe3;
            13'd309: base_coeff <= 16'h0056;
            13'd310: base_coeff <= 16'hff75;
            13'd311: base_coeff <= 16'h00ab;
            13'd312: base_coeff <= 16'hff57;
            13'd313: base_coeff <= 16'h007b;
            13'd314: base_coeff <= 16'hffdd;
            13'd315: base_coeff <= 16'hffaa;
            13'd316: base_coeff <= 16'h00d9;
            13'd317: base_coeff <= 16'hfeb8;
            13'd318: base_coeff <= 16'h0183;
            13'd319: base_coeff <= 16'hfe92;
            13'd320: base_coeff <= 16'h00f9;
            13'd321: base_coeff <= 16'hffd6;
            13'd322: base_coeff <= 16'hff1a;
            13'd323: base_coeff <= 16'h0206;
            13'd324: base_coeff <= 16'hfd0b;
            13'd325: base_coeff <= 16'h036d;
            13'd326: base_coeff <= 16'hfccf;
            13'd327: base_coeff <= 16'h0215;
            13'd328: base_coeff <= 16'hfff1;
            13'd329: base_coeff <= 16'hfd3b;
            13'd330: base_coeff <= 16'h0625;
            13'd331: base_coeff <= 16'hf653;
            13'd332: base_coeff <= 16'h0ce3;
            13'd333: base_coeff <= 16'hf0cb;
            13'd334: base_coeff <= 16'h0fa6;
            13'd335: base_coeff <= 16'h6d49;
            13'd336: base_coeff <= 16'h1461;
            13'd337: base_coeff <= 16'hef1c;
            13'd338: base_coeff <= 16'h0d5b;
            13'd339: base_coeff <= 16'hf680;
            13'd340: base_coeff <= 16'h05a2;
            13'd341: base_coeff <= 16'hfddc;
            13'd342: base_coeff <= 16'hff5a;
            13'd343: base_coeff <= 16'h0288;
            13'd344: base_coeff <= 16'hfc8c;
            13'd345: base_coeff <= 16'h037f;
            13'd346: base_coeff <= 16'hfd23;
            13'd347: base_coeff <= 16'h01d2;
            13'd348: base_coeff <= 16'hff59;
            13'd349: base_coeff <= 16'hff9a;
            13'd350: base_coeff <= 16'h0127;
            13'd351: base_coeff <= 16'hfe79;
            13'd352: base_coeff <= 16'h0188;
            13'd353: base_coeff <= 16'hfec5;
            13'd354: base_coeff <= 16'h00c0;
            13'd355: base_coeff <= 16'hffc7;
            13'd356: base_coeff <= 16'hffc3;
            13'd357: base_coeff <= 16'h008f;
            13'd358: base_coeff <= 16'hff4d;
            13'd359: base_coeff <= 16'h00ac;
            13'd360: base_coeff <= 16'hff7c;
            13'd361: base_coeff <= 16'h004b;
            13'd362: base_coeff <= 16'hfff0;
            13'd363: base_coeff <= 16'hffe0;
            13'd364: base_coeff <= 16'h003e;
            13'd365: base_coeff <= 16'hffb8;
            13'd366: base_coeff <= 16'h0041;
            13'd367: base_coeff <= 16'hffd1;
            13'd368: base_coeff <= 16'h0018;
            13'd369: base_coeff <= 16'hfffd;
            13'd370: base_coeff <= 16'hfff3;
            13'd371: base_coeff <= 16'h0015;
            13'd372: base_coeff <= 16'hffe9;
            13'd373: base_coeff <= 16'h0013;
            13'd374: base_coeff <= 16'hfff3;
            13'd375: base_coeff <= 16'h0006;
            13'd376: base_coeff <= 16'h0000;
            13'd377: base_coeff <= 16'hfffd;
            13'd378: base_coeff <= 16'h0005;
            13'd379: base_coeff <= 16'hfffc;
            13'd380: base_coeff <= 16'h0003;
            13'd381: base_coeff <= 16'hfffe;
            13'd382: base_coeff <= 16'h0001;
            13'd383: base_coeff <= 16'h0000;
            13'd384: base_coeff <= 16'h0001;
            13'd385: base_coeff <= 16'hfffe;
            13'd386: base_coeff <= 16'h0003;
            13'd387: base_coeff <= 16'hfffc;
            13'd388: base_coeff <= 16'h0004;
            13'd389: base_coeff <= 16'hfffe;
            13'd390: base_coeff <= 16'hffff;
            13'd391: base_coeff <= 16'h0007;
            13'd392: base_coeff <= 16'hfff3;
            13'd393: base_coeff <= 16'h0013;
            13'd394: base_coeff <= 16'hffea;
            13'd395: base_coeff <= 16'h0012;
            13'd396: base_coeff <= 16'hfff7;
            13'd397: base_coeff <= 16'hfff8;
            13'd398: base_coeff <= 16'h001d;
            13'd399: base_coeff <= 16'hffce;
            13'd400: base_coeff <= 16'h0041;
            13'd401: base_coeff <= 16'hffbc;
            13'd402: base_coeff <= 16'h0035;
            13'd403: base_coeff <= 16'hffed;
            13'd404: base_coeff <= 16'hffe1;
            13'd405: base_coeff <= 16'h0058;
            13'd406: base_coeff <= 16'hff74;
            13'd407: base_coeff <= 16'h00aa;
            13'd408: base_coeff <= 16'hff59;
            13'd409: base_coeff <= 16'h0078;
            13'd410: base_coeff <= 16'hffe2;
            13'd411: base_coeff <= 16'hffa5;
            13'd412: base_coeff <= 16'h00dd;
            13'd413: base_coeff <= 16'hfeb6;
            13'd414: base_coeff <= 16'h0182;
            13'd415: base_coeff <= 16'hfe97;
            13'd416: base_coeff <= 16'h00f1;
            13'd417: base_coeff <= 16'hffe0;
            13'd418: base_coeff <= 16'hff10;
            13'd419: base_coeff <= 16'h020d;
            13'd420: base_coeff <= 16'hfd08;
            13'd421: base_coeff <= 16'h0369;
            13'd422: base_coeff <= 16'hfcdb;
            13'd423: base_coeff <= 16'h0201;
            13'd424: base_coeff <= 16'h000a;
            13'd425: base_coeff <= 16'hfd21;
            13'd426: base_coeff <= 16'h0639;
            13'd427: base_coeff <= 16'hf64e;
            13'd428: base_coeff <= 16'h0ccb;
            13'd429: base_coeff <= 16'hf115;
            13'd430: base_coeff <= 16'h0ee1;
            13'd431: base_coeff <= 16'h6d3d;
            13'd432: base_coeff <= 16'h152f;
            13'd433: base_coeff <= 16'heed8;
            13'd434: base_coeff <= 16'h0d6c;
            13'd435: base_coeff <= 16'hf68b;
            13'd436: base_coeff <= 16'h058a;
            13'd437: base_coeff <= 16'hfdf8;
            13'd438: base_coeff <= 16'hff40;
            13'd439: base_coeff <= 16'h029b;
            13'd440: base_coeff <= 16'hfc82;
            13'd441: base_coeff <= 16'h0381;
            13'd442: base_coeff <= 16'hfd28;
            13'd443: base_coeff <= 16'h01c9;
            13'd444: base_coeff <= 16'hff64;
            13'd445: base_coeff <= 16'hff90;
            13'd446: base_coeff <= 16'h012f;
            13'd447: base_coeff <= 16'hfe75;
            13'd448: base_coeff <= 16'h0188;
            13'd449: base_coeff <= 16'hfec7;
            13'd450: base_coeff <= 16'h00bc;
            13'd451: base_coeff <= 16'hffcc;
            13'd452: base_coeff <= 16'hffbe;
            13'd453: base_coeff <= 16'h0092;
            13'd454: base_coeff <= 16'hff4c;
            13'd455: base_coeff <= 16'h00ac;
            13'd456: base_coeff <= 16'hff7d;
            13'd457: base_coeff <= 16'h0049;
            13'd458: base_coeff <= 16'hfff2;
            13'd459: base_coeff <= 16'hffdf;
            13'd460: base_coeff <= 16'h003f;
            13'd461: base_coeff <= 16'hffb7;
            13'd462: base_coeff <= 16'h0041;
            13'd463: base_coeff <= 16'hffd1;
            13'd464: base_coeff <= 16'h0018;
            13'd465: base_coeff <= 16'hfffe;
            13'd466: base_coeff <= 16'hfff3;
            13'd467: base_coeff <= 16'h0016;
            13'd468: base_coeff <= 16'hffe9;
            13'd469: base_coeff <= 16'h0013;
            13'd470: base_coeff <= 16'hfff4;
            13'd471: base_coeff <= 16'h0005;
            13'd472: base_coeff <= 16'h0000;
            13'd473: base_coeff <= 16'hfffd;
            13'd474: base_coeff <= 16'h0005;
            13'd475: base_coeff <= 16'hfffc;
            13'd476: base_coeff <= 16'h0003;
            13'd477: base_coeff <= 16'hfffe;
            13'd478: base_coeff <= 16'h0001;
            13'd479: base_coeff <= 16'h0000;
            13'd480: base_coeff <= 16'h0001;
            13'd481: base_coeff <= 16'hfffe;
            13'd482: base_coeff <= 16'h0003;
            13'd483: base_coeff <= 16'hfffc;
            13'd484: base_coeff <= 16'h0004;
            13'd485: base_coeff <= 16'hfffe;
            13'd486: base_coeff <= 16'hfffe;
            13'd487: base_coeff <= 16'h0007;
            13'd488: base_coeff <= 16'hfff2;
            13'd489: base_coeff <= 16'h0013;
            13'd490: base_coeff <= 16'hffeb;
            13'd491: base_coeff <= 16'h0012;
            13'd492: base_coeff <= 16'hfff8;
            13'd493: base_coeff <= 16'hfff7;
            13'd494: base_coeff <= 16'h001e;
            13'd495: base_coeff <= 16'hffcd;
            13'd496: base_coeff <= 16'h0041;
            13'd497: base_coeff <= 16'hffbd;
            13'd498: base_coeff <= 16'h0034;
            13'd499: base_coeff <= 16'hffef;
            13'd500: base_coeff <= 16'hffdf;
            13'd501: base_coeff <= 16'h005a;
            13'd502: base_coeff <= 16'hff73;
            13'd503: base_coeff <= 16'h00aa;
            13'd504: base_coeff <= 16'hff5b;
            13'd505: base_coeff <= 16'h0074;
            13'd506: base_coeff <= 16'hffe6;
            13'd507: base_coeff <= 16'hffa1;
            13'd508: base_coeff <= 16'h00e1;
            13'd509: base_coeff <= 16'hfeb4;
            13'd510: base_coeff <= 16'h0180;
            13'd511: base_coeff <= 16'hfe9c;
            13'd512: base_coeff <= 16'h00e9;
            13'd513: base_coeff <= 16'hffea;
            13'd514: base_coeff <= 16'hff06;
            13'd515: base_coeff <= 16'h0215;
            13'd516: base_coeff <= 16'hfd05;
            13'd517: base_coeff <= 16'h0365;
            13'd518: base_coeff <= 16'hfce8;
            13'd519: base_coeff <= 16'h01ed;
            13'd520: base_coeff <= 16'h0024;
            13'd521: base_coeff <= 16'hfd07;
            13'd522: base_coeff <= 16'h064d;
            13'd523: base_coeff <= 16'hf64a;
            13'd524: base_coeff <= 16'h0cb3;
            13'd525: base_coeff <= 16'hf161;
            13'd526: base_coeff <= 16'h0e1c;
            13'd527: base_coeff <= 16'h6d32;
            13'd528: base_coeff <= 16'h15fe;
            13'd529: base_coeff <= 16'hee94;
            13'd530: base_coeff <= 16'h0d7b;
            13'd531: base_coeff <= 16'hf696;
            13'd532: base_coeff <= 16'h0571;
            13'd533: base_coeff <= 16'hfe14;
            13'd534: base_coeff <= 16'hff27;
            13'd535: base_coeff <= 16'h02ae;
            13'd536: base_coeff <= 16'hfc78;
            13'd537: base_coeff <= 16'h0382;
            13'd538: base_coeff <= 16'hfd2d;
            13'd539: base_coeff <= 16'h01bf;
            13'd540: base_coeff <= 16'hff6f;
            13'd541: base_coeff <= 16'hff86;
            13'd542: base_coeff <= 16'h0136;
            13'd543: base_coeff <= 16'hfe71;
            13'd544: base_coeff <= 16'h0188;
            13'd545: base_coeff <= 16'hfeca;
            13'd546: base_coeff <= 16'h00b8;
            13'd547: base_coeff <= 16'hffd1;
            13'd548: base_coeff <= 16'hffba;
            13'd549: base_coeff <= 16'h0095;
            13'd550: base_coeff <= 16'hff4a;
            13'd551: base_coeff <= 16'h00ac;
            13'd552: base_coeff <= 16'hff7e;
            13'd553: base_coeff <= 16'h0047;
            13'd554: base_coeff <= 16'hfff4;
            13'd555: base_coeff <= 16'hffdd;
            13'd556: base_coeff <= 16'h0040;
            13'd557: base_coeff <= 16'hffb7;
            13'd558: base_coeff <= 16'h0041;
            13'd559: base_coeff <= 16'hffd2;
            13'd560: base_coeff <= 16'h0017;
            13'd561: base_coeff <= 16'hfffe;
            13'd562: base_coeff <= 16'hfff2;
            13'd563: base_coeff <= 16'h0016;
            13'd564: base_coeff <= 16'hffe9;
            13'd565: base_coeff <= 16'h0013;
            13'd566: base_coeff <= 16'hfff4;
            13'd567: base_coeff <= 16'h0005;
            13'd568: base_coeff <= 16'h0000;
            13'd569: base_coeff <= 16'hfffc;
            13'd570: base_coeff <= 16'h0005;
            13'd571: base_coeff <= 16'hfffc;
            13'd572: base_coeff <= 16'h0003;
            13'd573: base_coeff <= 16'hfffe;
            13'd574: base_coeff <= 16'h0001;
            13'd575: base_coeff <= 16'h0000;
            13'd576: base_coeff <= 16'h0001;
            13'd577: base_coeff <= 16'hfffe;
            13'd578: base_coeff <= 16'h0003;
            13'd579: base_coeff <= 16'hfffc;
            13'd580: base_coeff <= 16'h0004;
            13'd581: base_coeff <= 16'hfffe;
            13'd582: base_coeff <= 16'hfffe;
            13'd583: base_coeff <= 16'h0007;
            13'd584: base_coeff <= 16'hfff2;
            13'd585: base_coeff <= 16'h0013;
            13'd586: base_coeff <= 16'hffeb;
            13'd587: base_coeff <= 16'h0012;
            13'd588: base_coeff <= 16'hfff9;
            13'd589: base_coeff <= 16'hfff6;
            13'd590: base_coeff <= 16'h001f;
            13'd591: base_coeff <= 16'hffcd;
            13'd592: base_coeff <= 16'h0041;
            13'd593: base_coeff <= 16'hffbd;
            13'd594: base_coeff <= 16'h0032;
            13'd595: base_coeff <= 16'hfff1;
            13'd596: base_coeff <= 16'hffdd;
            13'd597: base_coeff <= 16'h005b;
            13'd598: base_coeff <= 16'hff73;
            13'd599: base_coeff <= 16'h00aa;
            13'd600: base_coeff <= 16'hff5d;
            13'd601: base_coeff <= 16'h0071;
            13'd602: base_coeff <= 16'hffeb;
            13'd603: base_coeff <= 16'hff9c;
            13'd604: base_coeff <= 16'h00e4;
            13'd605: base_coeff <= 16'hfeb3;
            13'd606: base_coeff <= 16'h017f;
            13'd607: base_coeff <= 16'hfea1;
            13'd608: base_coeff <= 16'h00e1;
            13'd609: base_coeff <= 16'hfff4;
            13'd610: base_coeff <= 16'hfefc;
            13'd611: base_coeff <= 16'h021d;
            13'd612: base_coeff <= 16'hfd03;
            13'd613: base_coeff <= 16'h0361;
            13'd614: base_coeff <= 16'hfcf4;
            13'd615: base_coeff <= 16'h01d9;
            13'd616: base_coeff <= 16'h003d;
            13'd617: base_coeff <= 16'hfcee;
            13'd618: base_coeff <= 16'h065f;
            13'd619: base_coeff <= 16'hf647;
            13'd620: base_coeff <= 16'h0c99;
            13'd621: base_coeff <= 16'hf1ad;
            13'd622: base_coeff <= 16'h0d5a;
            13'd623: base_coeff <= 16'h6d1f;
            13'd624: base_coeff <= 16'h16cf;
            13'd625: base_coeff <= 16'hee52;
            13'd626: base_coeff <= 16'h0d89;
            13'd627: base_coeff <= 16'hf6a3;
            13'd628: base_coeff <= 16'h0558;
            13'd629: base_coeff <= 16'hfe31;
            13'd630: base_coeff <= 16'hff0e;
            13'd631: base_coeff <= 16'h02c0;
            13'd632: base_coeff <= 16'hfc6e;
            13'd633: base_coeff <= 16'h0384;
            13'd634: base_coeff <= 16'hfd33;
            13'd635: base_coeff <= 16'h01b6;
            13'd636: base_coeff <= 16'hff7a;
            13'd637: base_coeff <= 16'hff7c;
            13'd638: base_coeff <= 16'h013d;
            13'd639: base_coeff <= 16'hfe6d;
            13'd640: base_coeff <= 16'h0188;
            13'd641: base_coeff <= 16'hfecd;
            13'd642: base_coeff <= 16'h00b3;
            13'd643: base_coeff <= 16'hffd6;
            13'd644: base_coeff <= 16'hffb5;
            13'd645: base_coeff <= 16'h0098;
            13'd646: base_coeff <= 16'hff49;
            13'd647: base_coeff <= 16'h00ab;
            13'd648: base_coeff <= 16'hff80;
            13'd649: base_coeff <= 16'h0045;
            13'd650: base_coeff <= 16'hfff6;
            13'd651: base_coeff <= 16'hffdb;
            13'd652: base_coeff <= 16'h0041;
            13'd653: base_coeff <= 16'hffb6;
            13'd654: base_coeff <= 16'h0041;
            13'd655: base_coeff <= 16'hffd2;
            13'd656: base_coeff <= 16'h0016;
            13'd657: base_coeff <= 16'hffff;
            13'd658: base_coeff <= 16'hfff1;
            13'd659: base_coeff <= 16'h0016;
            13'd660: base_coeff <= 16'hffe9;
            13'd661: base_coeff <= 16'h0013;
            13'd662: base_coeff <= 16'hfff4;
            13'd663: base_coeff <= 16'h0005;
            13'd664: base_coeff <= 16'h0000;
            13'd665: base_coeff <= 16'hfffc;
            13'd666: base_coeff <= 16'h0005;
            13'd667: base_coeff <= 16'hfffc;
            13'd668: base_coeff <= 16'h0003;
            13'd669: base_coeff <= 16'hfffe;
            13'd670: base_coeff <= 16'h0000;
            13'd671: base_coeff <= 16'h0000;
            13'd672: base_coeff <= 16'h0001;
            13'd673: base_coeff <= 16'hfffe;
            13'd674: base_coeff <= 16'h0003;
            13'd675: base_coeff <= 16'hfffc;
            13'd676: base_coeff <= 16'h0004;
            13'd677: base_coeff <= 16'hfffe;
            13'd678: base_coeff <= 16'hfffe;
            13'd679: base_coeff <= 16'h0007;
            13'd680: base_coeff <= 16'hfff2;
            13'd681: base_coeff <= 16'h0013;
            13'd682: base_coeff <= 16'hffeb;
            13'd683: base_coeff <= 16'h0011;
            13'd684: base_coeff <= 16'hfff9;
            13'd685: base_coeff <= 16'hfff6;
            13'd686: base_coeff <= 16'h001f;
            13'd687: base_coeff <= 16'hffcc;
            13'd688: base_coeff <= 16'h0041;
            13'd689: base_coeff <= 16'hffbe;
            13'd690: base_coeff <= 16'h0031;
            13'd691: base_coeff <= 16'hfff3;
            13'd692: base_coeff <= 16'hffdb;
            13'd693: base_coeff <= 16'h005d;
            13'd694: base_coeff <= 16'hff72;
            13'd695: base_coeff <= 16'h00a9;
            13'd696: base_coeff <= 16'hff5f;
            13'd697: base_coeff <= 16'h006d;
            13'd698: base_coeff <= 16'hffef;
            13'd699: base_coeff <= 16'hff97;
            13'd700: base_coeff <= 16'h00e8;
            13'd701: base_coeff <= 16'hfeb1;
            13'd702: base_coeff <= 16'h017d;
            13'd703: base_coeff <= 16'hfea6;
            13'd704: base_coeff <= 16'h00d9;
            13'd705: base_coeff <= 16'hfffe;
            13'd706: base_coeff <= 16'hfef2;
            13'd707: base_coeff <= 16'h0224;
            13'd708: base_coeff <= 16'hfd01;
            13'd709: base_coeff <= 16'h035c;
            13'd710: base_coeff <= 16'hfd01;
            13'd711: base_coeff <= 16'h01c5;
            13'd712: base_coeff <= 16'h0055;
            13'd713: base_coeff <= 16'hfcd5;
            13'd714: base_coeff <= 16'h0671;
            13'd715: base_coeff <= 16'hf645;
            13'd716: base_coeff <= 16'h0c7f;
            13'd717: base_coeff <= 16'hf1fa;
            13'd718: base_coeff <= 16'h0c98;
            13'd719: base_coeff <= 16'h6d0c;
            13'd720: base_coeff <= 16'h17a0;
            13'd721: base_coeff <= 16'hee10;
            13'd722: base_coeff <= 16'h0d96;
            13'd723: base_coeff <= 16'hf6b0;
            13'd724: base_coeff <= 16'h053f;
            13'd725: base_coeff <= 16'hfe4d;
            13'd726: base_coeff <= 16'hfef4;
            13'd727: base_coeff <= 16'h02d2;
            13'd728: base_coeff <= 16'hfc65;
            13'd729: base_coeff <= 16'h0385;
            13'd730: base_coeff <= 16'hfd38;
            13'd731: base_coeff <= 16'h01ac;
            13'd732: base_coeff <= 16'hff85;
            13'd733: base_coeff <= 16'hff72;
            13'd734: base_coeff <= 16'h0144;
            13'd735: base_coeff <= 16'hfe6a;
            13'd736: base_coeff <= 16'h0188;
            13'd737: base_coeff <= 16'hfed0;
            13'd738: base_coeff <= 16'h00af;
            13'd739: base_coeff <= 16'hffdb;
            13'd740: base_coeff <= 16'hffb1;
            13'd741: base_coeff <= 16'h009b;
            13'd742: base_coeff <= 16'hff47;
            13'd743: base_coeff <= 16'h00ab;
            13'd744: base_coeff <= 16'hff81;
            13'd745: base_coeff <= 16'h0043;
            13'd746: base_coeff <= 16'hfff8;
            13'd747: base_coeff <= 16'hffd9;
            13'd748: base_coeff <= 16'h0043;
            13'd749: base_coeff <= 16'hffb6;
            13'd750: base_coeff <= 16'h0041;
            13'd751: base_coeff <= 16'hffd3;
            13'd752: base_coeff <= 16'h0016;
            13'd753: base_coeff <= 16'h0000;
            13'd754: base_coeff <= 16'hfff1;
            13'd755: base_coeff <= 16'h0017;
            13'd756: base_coeff <= 16'hffe9;
            13'd757: base_coeff <= 16'h0013;
            13'd758: base_coeff <= 16'hfff4;
            13'd759: base_coeff <= 16'h0005;
            13'd760: base_coeff <= 16'h0001;
            13'd761: base_coeff <= 16'hfffc;
            13'd762: base_coeff <= 16'h0005;
            13'd763: base_coeff <= 16'hfffc;
            13'd764: base_coeff <= 16'h0003;
            13'd765: base_coeff <= 16'hfffe;
            13'd766: base_coeff <= 16'h0000;
            13'd767: base_coeff <= 16'h0000;
            13'd768: base_coeff <= 16'h0001;
            13'd769: base_coeff <= 16'hfffe;
            13'd770: base_coeff <= 16'h0003;
            13'd771: base_coeff <= 16'hfffc;
            13'd772: base_coeff <= 16'h0004;
            13'd773: base_coeff <= 16'hfffe;
            13'd774: base_coeff <= 16'hfffe;
            13'd775: base_coeff <= 16'h0008;
            13'd776: base_coeff <= 16'hfff2;
            13'd777: base_coeff <= 16'h0013;
            13'd778: base_coeff <= 16'hffeb;
            13'd779: base_coeff <= 16'h0011;
            13'd780: base_coeff <= 16'hfffa;
            13'd781: base_coeff <= 16'hfff5;
            13'd782: base_coeff <= 16'h0020;
            13'd783: base_coeff <= 16'hffcc;
            13'd784: base_coeff <= 16'h0041;
            13'd785: base_coeff <= 16'hffbf;
            13'd786: base_coeff <= 16'h0030;
            13'd787: base_coeff <= 16'hfff4;
            13'd788: base_coeff <= 16'hffd9;
            13'd789: base_coeff <= 16'h005f;
            13'd790: base_coeff <= 16'hff71;
            13'd791: base_coeff <= 16'h00a9;
            13'd792: base_coeff <= 16'hff61;
            13'd793: base_coeff <= 16'h006a;
            13'd794: base_coeff <= 16'hfff4;
            13'd795: base_coeff <= 16'hff93;
            13'd796: base_coeff <= 16'h00eb;
            13'd797: base_coeff <= 16'hfeb0;
            13'd798: base_coeff <= 16'h017c;
            13'd799: base_coeff <= 16'hfeab;
            13'd800: base_coeff <= 16'h00d1;
            13'd801: base_coeff <= 16'h0008;
            13'd802: base_coeff <= 16'hfee8;
            13'd803: base_coeff <= 16'h022b;
            13'd804: base_coeff <= 16'hfcff;
            13'd805: base_coeff <= 16'h0357;
            13'd806: base_coeff <= 16'hfd0e;
            13'd807: base_coeff <= 16'h01b0;
            13'd808: base_coeff <= 16'h006e;
            13'd809: base_coeff <= 16'hfcbc;
            13'd810: base_coeff <= 16'h0683;
            13'd811: base_coeff <= 16'hf644;
            13'd812: base_coeff <= 16'h0c63;
            13'd813: base_coeff <= 16'hf247;
            13'd814: base_coeff <= 16'h0bd8;
            13'd815: base_coeff <= 16'h6cf1;
            13'd816: base_coeff <= 16'h1872;
            13'd817: base_coeff <= 16'hedd0;
            13'd818: base_coeff <= 16'h0da2;
            13'd819: base_coeff <= 16'hf6be;
            13'd820: base_coeff <= 16'h0525;
            13'd821: base_coeff <= 16'hfe6a;
            13'd822: base_coeff <= 16'hfedb;
            13'd823: base_coeff <= 16'h02e4;
            13'd824: base_coeff <= 16'hfc5c;
            13'd825: base_coeff <= 16'h0385;
            13'd826: base_coeff <= 16'hfd3e;
            13'd827: base_coeff <= 16'h01a2;
            13'd828: base_coeff <= 16'hff90;
            13'd829: base_coeff <= 16'hff69;
            13'd830: base_coeff <= 16'h014b;
            13'd831: base_coeff <= 16'hfe67;
            13'd832: base_coeff <= 16'h0188;
            13'd833: base_coeff <= 16'hfed3;
            13'd834: base_coeff <= 16'h00aa;
            13'd835: base_coeff <= 16'hffe0;
            13'd836: base_coeff <= 16'hffad;
            13'd837: base_coeff <= 16'h009e;
            13'd838: base_coeff <= 16'hff46;
            13'd839: base_coeff <= 16'h00ab;
            13'd840: base_coeff <= 16'hff83;
            13'd841: base_coeff <= 16'h0041;
            13'd842: base_coeff <= 16'hfffa;
            13'd843: base_coeff <= 16'hffd7;
            13'd844: base_coeff <= 16'h0044;
            13'd845: base_coeff <= 16'hffb5;
            13'd846: base_coeff <= 16'h0041;
            13'd847: base_coeff <= 16'hffd3;
            13'd848: base_coeff <= 16'h0015;
            13'd849: base_coeff <= 16'h0001;
            13'd850: base_coeff <= 16'hfff0;
            13'd851: base_coeff <= 16'h0017;
            13'd852: base_coeff <= 16'hffe9;
            13'd853: base_coeff <= 16'h0013;
            13'd854: base_coeff <= 16'hfff4;
            13'd855: base_coeff <= 16'h0005;
            13'd856: base_coeff <= 16'h0001;
            13'd857: base_coeff <= 16'hfffc;
            13'd858: base_coeff <= 16'h0005;
            13'd859: base_coeff <= 16'hfffc;
            13'd860: base_coeff <= 16'h0003;
            13'd861: base_coeff <= 16'hfffe;
            13'd862: base_coeff <= 16'h0000;
            13'd863: base_coeff <= 16'h0000;
            13'd864: base_coeff <= 16'h0001;
            13'd865: base_coeff <= 16'hfffe;
            13'd866: base_coeff <= 16'h0003;
            13'd867: base_coeff <= 16'hfffc;
            13'd868: base_coeff <= 16'h0004;
            13'd869: base_coeff <= 16'hfffe;
            13'd870: base_coeff <= 16'hfffe;
            13'd871: base_coeff <= 16'h0008;
            13'd872: base_coeff <= 16'hfff2;
            13'd873: base_coeff <= 16'h0013;
            13'd874: base_coeff <= 16'hffec;
            13'd875: base_coeff <= 16'h0010;
            13'd876: base_coeff <= 16'hfffb;
            13'd877: base_coeff <= 16'hfff4;
            13'd878: base_coeff <= 16'h0020;
            13'd879: base_coeff <= 16'hffcc;
            13'd880: base_coeff <= 16'h0041;
            13'd881: base_coeff <= 16'hffc0;
            13'd882: base_coeff <= 16'h002e;
            13'd883: base_coeff <= 16'hfff6;
            13'd884: base_coeff <= 16'hffd7;
            13'd885: base_coeff <= 16'h0060;
            13'd886: base_coeff <= 16'hff70;
            13'd887: base_coeff <= 16'h00a8;
            13'd888: base_coeff <= 16'hff64;
            13'd889: base_coeff <= 16'h0066;
            13'd890: base_coeff <= 16'hfff8;
            13'd891: base_coeff <= 16'hff8e;
            13'd892: base_coeff <= 16'h00ef;
            13'd893: base_coeff <= 16'hfeaf;
            13'd894: base_coeff <= 16'h017a;
            13'd895: base_coeff <= 16'hfeb0;
            13'd896: base_coeff <= 16'h00c9;
            13'd897: base_coeff <= 16'h0012;
            13'd898: base_coeff <= 16'hfede;
            13'd899: base_coeff <= 16'h0232;
            13'd900: base_coeff <= 16'hfcfd;
            13'd901: base_coeff <= 16'h0351;
            13'd902: base_coeff <= 16'hfd1b;
            13'd903: base_coeff <= 16'h019c;
            13'd904: base_coeff <= 16'h0087;
            13'd905: base_coeff <= 16'hfca4;
            13'd906: base_coeff <= 16'h0694;
            13'd907: base_coeff <= 16'hf643;
            13'd908: base_coeff <= 16'h0c47;
            13'd909: base_coeff <= 16'hf296;
            13'd910: base_coeff <= 16'h0b1a;
            13'd911: base_coeff <= 16'h6cd8;
            13'd912: base_coeff <= 16'h1945;
            13'd913: base_coeff <= 16'hed91;
            13'd914: base_coeff <= 16'h0dad;
            13'd915: base_coeff <= 16'hf6cd;
            13'd916: base_coeff <= 16'h050a;
            13'd917: base_coeff <= 16'hfe87;
            13'd918: base_coeff <= 16'hfec2;
            13'd919: base_coeff <= 16'h02f6;
            13'd920: base_coeff <= 16'hfc53;
            13'd921: base_coeff <= 16'h0386;
            13'd922: base_coeff <= 16'hfd44;
            13'd923: base_coeff <= 16'h0198;
            13'd924: base_coeff <= 16'hff9b;
            13'd925: base_coeff <= 16'hff5f;
            13'd926: base_coeff <= 16'h0152;
            13'd927: base_coeff <= 16'hfe63;
            13'd928: base_coeff <= 16'h0188;
            13'd929: base_coeff <= 16'hfed6;
            13'd930: base_coeff <= 16'h00a5;
            13'd931: base_coeff <= 16'hffe5;
            13'd932: base_coeff <= 16'hffa8;
            13'd933: base_coeff <= 16'h00a1;
            13'd934: base_coeff <= 16'hff45;
            13'd935: base_coeff <= 16'h00aa;
            13'd936: base_coeff <= 16'hff84;
            13'd937: base_coeff <= 16'h003f;
            13'd938: base_coeff <= 16'hfffc;
            13'd939: base_coeff <= 16'hffd6;
            13'd940: base_coeff <= 16'h0045;
            13'd941: base_coeff <= 16'hffb5;
            13'd942: base_coeff <= 16'h0041;
            13'd943: base_coeff <= 16'hffd4;
            13'd944: base_coeff <= 16'h0014;
            13'd945: base_coeff <= 16'h0001;
            13'd946: base_coeff <= 16'hfff0;
            13'd947: base_coeff <= 16'h0017;
            13'd948: base_coeff <= 16'hffe9;
            13'd949: base_coeff <= 16'h0013;
            13'd950: base_coeff <= 16'hfff4;
            13'd951: base_coeff <= 16'h0004;
            13'd952: base_coeff <= 16'h0001;
            13'd953: base_coeff <= 16'hfffc;
            13'd954: base_coeff <= 16'h0005;
            13'd955: base_coeff <= 16'hfffc;
            13'd956: base_coeff <= 16'h0003;
            13'd957: base_coeff <= 16'hffff;
            13'd958: base_coeff <= 16'h0000;
            13'd959: base_coeff <= 16'h0000;
            13'd960: base_coeff <= 16'h0001;
            13'd961: base_coeff <= 16'hfffe;
            13'd962: base_coeff <= 16'h0003;
            13'd963: base_coeff <= 16'hfffc;
            13'd964: base_coeff <= 16'h0004;
            13'd965: base_coeff <= 16'hfffe;
            13'd966: base_coeff <= 16'hfffe;
            13'd967: base_coeff <= 16'h0008;
            13'd968: base_coeff <= 16'hfff2;
            13'd969: base_coeff <= 16'h0013;
            13'd970: base_coeff <= 16'hffec;
            13'd971: base_coeff <= 16'h0010;
            13'd972: base_coeff <= 16'hfffb;
            13'd973: base_coeff <= 16'hfff4;
            13'd974: base_coeff <= 16'h0021;
            13'd975: base_coeff <= 16'hffcc;
            13'd976: base_coeff <= 16'h0041;
            13'd977: base_coeff <= 16'hffc1;
            13'd978: base_coeff <= 16'h002d;
            13'd979: base_coeff <= 16'hfff8;
            13'd980: base_coeff <= 16'hffd5;
            13'd981: base_coeff <= 16'h0062;
            13'd982: base_coeff <= 16'hff70;
            13'd983: base_coeff <= 16'h00a7;
            13'd984: base_coeff <= 16'hff66;
            13'd985: base_coeff <= 16'h0063;
            13'd986: base_coeff <= 16'hfffd;
            13'd987: base_coeff <= 16'hff8a;
            13'd988: base_coeff <= 16'h00f2;
            13'd989: base_coeff <= 16'hfeae;
            13'd990: base_coeff <= 16'h0178;
            13'd991: base_coeff <= 16'hfeb6;
            13'd992: base_coeff <= 16'h00c0;
            13'd993: base_coeff <= 16'h001c;
            13'd994: base_coeff <= 16'hfed5;
            13'd995: base_coeff <= 16'h0239;
            13'd996: base_coeff <= 16'hfcfb;
            13'd997: base_coeff <= 16'h034c;
            13'd998: base_coeff <= 16'hfd29;
            13'd999: base_coeff <= 16'h0188;
            13'd1000: base_coeff <= 16'h00a0;
            13'd1001: base_coeff <= 16'hfc8c;
            13'd1002: base_coeff <= 16'h06a4;
            13'd1003: base_coeff <= 16'hf643;
            13'd1004: base_coeff <= 16'h0c2a;
            13'd1005: base_coeff <= 16'hf2e4;
            13'd1006: base_coeff <= 16'h0a5d;
            13'd1007: base_coeff <= 16'h6cb6;
            13'd1008: base_coeff <= 16'h1a19;
            13'd1009: base_coeff <= 16'hed53;
            13'd1010: base_coeff <= 16'h0db7;
            13'd1011: base_coeff <= 16'hf6dc;
            13'd1012: base_coeff <= 16'h04ef;
            13'd1013: base_coeff <= 16'hfea4;
            13'd1014: base_coeff <= 16'hfea9;
            13'd1015: base_coeff <= 16'h0307;
            13'd1016: base_coeff <= 16'hfc4a;
            13'd1017: base_coeff <= 16'h0386;
            13'd1018: base_coeff <= 16'hfd4b;
            13'd1019: base_coeff <= 16'h018e;
            13'd1020: base_coeff <= 16'hffa6;
            13'd1021: base_coeff <= 16'hff55;
            13'd1022: base_coeff <= 16'h0159;
            13'd1023: base_coeff <= 16'hfe60;
            13'd1024: base_coeff <= 16'h0187;
            13'd1025: base_coeff <= 16'hfed9;
            13'd1026: base_coeff <= 16'h00a0;
            13'd1027: base_coeff <= 16'hffea;
            13'd1028: base_coeff <= 16'hffa4;
            13'd1029: base_coeff <= 16'h00a4;
            13'd1030: base_coeff <= 16'hff44;
            13'd1031: base_coeff <= 16'h00aa;
            13'd1032: base_coeff <= 16'hff86;
            13'd1033: base_coeff <= 16'h003d;
            13'd1034: base_coeff <= 16'hfffe;
            13'd1035: base_coeff <= 16'hffd4;
            13'd1036: base_coeff <= 16'h0046;
            13'd1037: base_coeff <= 16'hffb5;
            13'd1038: base_coeff <= 16'h0040;
            13'd1039: base_coeff <= 16'hffd5;
            13'd1040: base_coeff <= 16'h0013;
            13'd1041: base_coeff <= 16'h0002;
            13'd1042: base_coeff <= 16'hffef;
            13'd1043: base_coeff <= 16'h0018;
            13'd1044: base_coeff <= 16'hffe8;
            13'd1045: base_coeff <= 16'h0013;
            13'd1046: base_coeff <= 16'hfff5;
            13'd1047: base_coeff <= 16'h0004;
            13'd1048: base_coeff <= 16'h0001;
            13'd1049: base_coeff <= 16'hfffc;
            13'd1050: base_coeff <= 16'h0005;
            13'd1051: base_coeff <= 16'hfffc;
            13'd1052: base_coeff <= 16'h0003;
            13'd1053: base_coeff <= 16'hffff;
            13'd1054: base_coeff <= 16'h0000;
            13'd1055: base_coeff <= 16'h0000;
            13'd1056: base_coeff <= 16'h0001;
            13'd1057: base_coeff <= 16'hfffe;
            13'd1058: base_coeff <= 16'h0003;
            13'd1059: base_coeff <= 16'hfffc;
            13'd1060: base_coeff <= 16'h0003;
            13'd1061: base_coeff <= 16'hffff;
            13'd1062: base_coeff <= 16'hfffd;
            13'd1063: base_coeff <= 16'h0008;
            13'd1064: base_coeff <= 16'hfff2;
            13'd1065: base_coeff <= 16'h0013;
            13'd1066: base_coeff <= 16'hffec;
            13'd1067: base_coeff <= 16'h000f;
            13'd1068: base_coeff <= 16'hfffc;
            13'd1069: base_coeff <= 16'hfff3;
            13'd1070: base_coeff <= 16'h0022;
            13'd1071: base_coeff <= 16'hffcb;
            13'd1072: base_coeff <= 16'h0040;
            13'd1073: base_coeff <= 16'hffc1;
            13'd1074: base_coeff <= 16'h002b;
            13'd1075: base_coeff <= 16'hfffa;
            13'd1076: base_coeff <= 16'hffd3;
            13'd1077: base_coeff <= 16'h0063;
            13'd1078: base_coeff <= 16'hff6f;
            13'd1079: base_coeff <= 16'h00a6;
            13'd1080: base_coeff <= 16'hff68;
            13'd1081: base_coeff <= 16'h005f;
            13'd1082: base_coeff <= 16'h0001;
            13'd1083: base_coeff <= 16'hff85;
            13'd1084: base_coeff <= 16'h00f5;
            13'd1085: base_coeff <= 16'hfead;
            13'd1086: base_coeff <= 16'h0176;
            13'd1087: base_coeff <= 16'hfebb;
            13'd1088: base_coeff <= 16'h00b8;
            13'd1089: base_coeff <= 16'h0026;
            13'd1090: base_coeff <= 16'hfecb;
            13'd1091: base_coeff <= 16'h0240;
            13'd1092: base_coeff <= 16'hfcfa;
            13'd1093: base_coeff <= 16'h0346;
            13'd1094: base_coeff <= 16'hfd37;
            13'd1095: base_coeff <= 16'h0173;
            13'd1096: base_coeff <= 16'h00b8;
            13'd1097: base_coeff <= 16'hfc74;
            13'd1098: base_coeff <= 16'h06b4;
            13'd1099: base_coeff <= 16'hf645;
            13'd1100: base_coeff <= 16'h0c0c;
            13'd1101: base_coeff <= 16'hf334;
            13'd1102: base_coeff <= 16'h09a2;
            13'd1103: base_coeff <= 16'h6c9b;
            13'd1104: base_coeff <= 16'h1aee;
            13'd1105: base_coeff <= 16'hed16;
            13'd1106: base_coeff <= 16'h0dc0;
            13'd1107: base_coeff <= 16'hf6ed;
            13'd1108: base_coeff <= 16'h04d3;
            13'd1109: base_coeff <= 16'hfec2;
            13'd1110: base_coeff <= 16'hfe90;
            13'd1111: base_coeff <= 16'h0319;
            13'd1112: base_coeff <= 16'hfc42;
            13'd1113: base_coeff <= 16'h0386;
            13'd1114: base_coeff <= 16'hfd51;
            13'd1115: base_coeff <= 16'h0184;
            13'd1116: base_coeff <= 16'hffb1;
            13'd1117: base_coeff <= 16'hff4b;
            13'd1118: base_coeff <= 16'h015f;
            13'd1119: base_coeff <= 16'hfe5d;
            13'd1120: base_coeff <= 16'h0186;
            13'd1121: base_coeff <= 16'hfedc;
            13'd1122: base_coeff <= 16'h009c;
            13'd1123: base_coeff <= 16'hffef;
            13'd1124: base_coeff <= 16'hffa0;
            13'd1125: base_coeff <= 16'h00a7;
            13'd1126: base_coeff <= 16'hff43;
            13'd1127: base_coeff <= 16'h00aa;
            13'd1128: base_coeff <= 16'hff87;
            13'd1129: base_coeff <= 16'h003b;
            13'd1130: base_coeff <= 16'h0001;
            13'd1131: base_coeff <= 16'hffd2;
            13'd1132: base_coeff <= 16'h0047;
            13'd1133: base_coeff <= 16'hffb4;
            13'd1134: base_coeff <= 16'h0040;
            13'd1135: base_coeff <= 16'hffd5;
            13'd1136: base_coeff <= 16'h0012;
            13'd1137: base_coeff <= 16'h0003;
            13'd1138: base_coeff <= 16'hffef;
            13'd1139: base_coeff <= 16'h0018;
            13'd1140: base_coeff <= 16'hffe8;
            13'd1141: base_coeff <= 16'h0012;
            13'd1142: base_coeff <= 16'hfff5;
            13'd1143: base_coeff <= 16'h0004;
            13'd1144: base_coeff <= 16'h0001;
            13'd1145: base_coeff <= 16'hfffc;
            13'd1146: base_coeff <= 16'h0005;
            13'd1147: base_coeff <= 16'hfffc;
            13'd1148: base_coeff <= 16'h0003;
            13'd1149: base_coeff <= 16'hffff;
            13'd1150: base_coeff <= 16'h0000;
            13'd1151: base_coeff <= 16'h0000;
            13'd1152: base_coeff <= 16'h0001;
            13'd1153: base_coeff <= 16'hfffe;
            13'd1154: base_coeff <= 16'h0003;
            13'd1155: base_coeff <= 16'hfffc;
            13'd1156: base_coeff <= 16'h0003;
            13'd1157: base_coeff <= 16'hffff;
            13'd1158: base_coeff <= 16'hfffd;
            13'd1159: base_coeff <= 16'h0008;
            13'd1160: base_coeff <= 16'hfff2;
            13'd1161: base_coeff <= 16'h0013;
            13'd1162: base_coeff <= 16'hffec;
            13'd1163: base_coeff <= 16'h000f;
            13'd1164: base_coeff <= 16'hfffc;
            13'd1165: base_coeff <= 16'hfff2;
            13'd1166: base_coeff <= 16'h0022;
            13'd1167: base_coeff <= 16'hffcb;
            13'd1168: base_coeff <= 16'h0040;
            13'd1169: base_coeff <= 16'hffc2;
            13'd1170: base_coeff <= 16'h002a;
            13'd1171: base_coeff <= 16'hfffc;
            13'd1172: base_coeff <= 16'hffd2;
            13'd1173: base_coeff <= 16'h0065;
            13'd1174: base_coeff <= 16'hff6f;
            13'd1175: base_coeff <= 16'h00a6;
            13'd1176: base_coeff <= 16'hff6a;
            13'd1177: base_coeff <= 16'h005b;
            13'd1178: base_coeff <= 16'h0006;
            13'd1179: base_coeff <= 16'hff81;
            13'd1180: base_coeff <= 16'h00f9;
            13'd1181: base_coeff <= 16'hfeac;
            13'd1182: base_coeff <= 16'h0174;
            13'd1183: base_coeff <= 16'hfec1;
            13'd1184: base_coeff <= 16'h00b0;
            13'd1185: base_coeff <= 16'h0030;
            13'd1186: base_coeff <= 16'hfec2;
            13'd1187: base_coeff <= 16'h0246;
            13'd1188: base_coeff <= 16'hfcf9;
            13'd1189: base_coeff <= 16'h0340;
            13'd1190: base_coeff <= 16'hfd44;
            13'd1191: base_coeff <= 16'h015e;
            13'd1192: base_coeff <= 16'h00d1;
            13'd1193: base_coeff <= 16'hfc5d;
            13'd1194: base_coeff <= 16'h06c3;
            13'd1195: base_coeff <= 16'hf647;
            13'd1196: base_coeff <= 16'h0bed;
            13'd1197: base_coeff <= 16'hf384;
            13'd1198: base_coeff <= 16'h08e8;
            13'd1199: base_coeff <= 16'h6c70;
            13'd1200: base_coeff <= 16'h1bc4;
            13'd1201: base_coeff <= 16'hecda;
            13'd1202: base_coeff <= 16'h0dc7;
            13'd1203: base_coeff <= 16'hf6fe;
            13'd1204: base_coeff <= 16'h04b7;
            13'd1205: base_coeff <= 16'hfedf;
            13'd1206: base_coeff <= 16'hfe77;
            13'd1207: base_coeff <= 16'h032a;
            13'd1208: base_coeff <= 16'hfc3a;
            13'd1209: base_coeff <= 16'h0385;
            13'd1210: base_coeff <= 16'hfd58;
            13'd1211: base_coeff <= 16'h0179;
            13'd1212: base_coeff <= 16'hffbd;
            13'd1213: base_coeff <= 16'hff42;
            13'd1214: base_coeff <= 16'h0166;
            13'd1215: base_coeff <= 16'hfe5b;
            13'd1216: base_coeff <= 16'h0186;
            13'd1217: base_coeff <= 16'hfee0;
            13'd1218: base_coeff <= 16'h0097;
            13'd1219: base_coeff <= 16'hfff4;
            13'd1220: base_coeff <= 16'hff9c;
            13'd1221: base_coeff <= 16'h00a9;
            13'd1222: base_coeff <= 16'hff42;
            13'd1223: base_coeff <= 16'h00a9;
            13'd1224: base_coeff <= 16'hff89;
            13'd1225: base_coeff <= 16'h0039;
            13'd1226: base_coeff <= 16'h0003;
            13'd1227: base_coeff <= 16'hffd0;
            13'd1228: base_coeff <= 16'h0048;
            13'd1229: base_coeff <= 16'hffb4;
            13'd1230: base_coeff <= 16'h0040;
            13'd1231: base_coeff <= 16'hffd6;
            13'd1232: base_coeff <= 16'h0012;
            13'd1233: base_coeff <= 16'h0004;
            13'd1234: base_coeff <= 16'hffee;
            13'd1235: base_coeff <= 16'h0018;
            13'd1236: base_coeff <= 16'hffe8;
            13'd1237: base_coeff <= 16'h0012;
            13'd1238: base_coeff <= 16'hfff5;
            13'd1239: base_coeff <= 16'h0004;
            13'd1240: base_coeff <= 16'h0002;
            13'd1241: base_coeff <= 16'hfffc;
            13'd1242: base_coeff <= 16'h0005;
            13'd1243: base_coeff <= 16'hfffc;
            13'd1244: base_coeff <= 16'h0003;
            13'd1245: base_coeff <= 16'hffff;
            13'd1246: base_coeff <= 16'h0000;
            13'd1247: base_coeff <= 16'h0000;
            13'd1248: base_coeff <= 16'h0001;
            13'd1249: base_coeff <= 16'hfffe;
            13'd1250: base_coeff <= 16'h0003;
            13'd1251: base_coeff <= 16'hfffc;
            13'd1252: base_coeff <= 16'h0003;
            13'd1253: base_coeff <= 16'hffff;
            13'd1254: base_coeff <= 16'hfffd;
            13'd1255: base_coeff <= 16'h0008;
            13'd1256: base_coeff <= 16'hfff2;
            13'd1257: base_coeff <= 16'h0013;
            13'd1258: base_coeff <= 16'hffec;
            13'd1259: base_coeff <= 16'h000f;
            13'd1260: base_coeff <= 16'hfffd;
            13'd1261: base_coeff <= 16'hfff2;
            13'd1262: base_coeff <= 16'h0023;
            13'd1263: base_coeff <= 16'hffcb;
            13'd1264: base_coeff <= 16'h0040;
            13'd1265: base_coeff <= 16'hffc3;
            13'd1266: base_coeff <= 16'h0028;
            13'd1267: base_coeff <= 16'hfffe;
            13'd1268: base_coeff <= 16'hffd0;
            13'd1269: base_coeff <= 16'h0066;
            13'd1270: base_coeff <= 16'hff6e;
            13'd1271: base_coeff <= 16'h00a5;
            13'd1272: base_coeff <= 16'hff6d;
            13'd1273: base_coeff <= 16'h0058;
            13'd1274: base_coeff <= 16'h000a;
            13'd1275: base_coeff <= 16'hff7d;
            13'd1276: base_coeff <= 16'h00fc;
            13'd1277: base_coeff <= 16'hfeab;
            13'd1278: base_coeff <= 16'h0171;
            13'd1279: base_coeff <= 16'hfec6;
            13'd1280: base_coeff <= 16'h00a7;
            13'd1281: base_coeff <= 16'h003a;
            13'd1282: base_coeff <= 16'hfeb9;
            13'd1283: base_coeff <= 16'h024c;
            13'd1284: base_coeff <= 16'hfcf8;
            13'd1285: base_coeff <= 16'h0339;
            13'd1286: base_coeff <= 16'hfd53;
            13'd1287: base_coeff <= 16'h014a;
            13'd1288: base_coeff <= 16'h00e9;
            13'd1289: base_coeff <= 16'hfc46;
            13'd1290: base_coeff <= 16'h06d2;
            13'd1291: base_coeff <= 16'hf649;
            13'd1292: base_coeff <= 16'h0bcd;
            13'd1293: base_coeff <= 16'hf3d4;
            13'd1294: base_coeff <= 16'h082f;
            13'd1295: base_coeff <= 16'h6c4d;
            13'd1296: base_coeff <= 16'h1c9a;
            13'd1297: base_coeff <= 16'hec9f;
            13'd1298: base_coeff <= 16'h0dce;
            13'd1299: base_coeff <= 16'hf710;
            13'd1300: base_coeff <= 16'h049b;
            13'd1301: base_coeff <= 16'hfefd;
            13'd1302: base_coeff <= 16'hfe5e;
            13'd1303: base_coeff <= 16'h033a;
            13'd1304: base_coeff <= 16'hfc33;
            13'd1305: base_coeff <= 16'h0384;
            13'd1306: base_coeff <= 16'hfd5f;
            13'd1307: base_coeff <= 16'h016f;
            13'd1308: base_coeff <= 16'hffc8;
            13'd1309: base_coeff <= 16'hff38;
            13'd1310: base_coeff <= 16'h016c;
            13'd1311: base_coeff <= 16'hfe58;
            13'd1312: base_coeff <= 16'h0185;
            13'd1313: base_coeff <= 16'hfee3;
            13'd1314: base_coeff <= 16'h0092;
            13'd1315: base_coeff <= 16'hfff9;
            13'd1316: base_coeff <= 16'hff97;
            13'd1317: base_coeff <= 16'h00ac;
            13'd1318: base_coeff <= 16'hff41;
            13'd1319: base_coeff <= 16'h00a9;
            13'd1320: base_coeff <= 16'hff8b;
            13'd1321: base_coeff <= 16'h0036;
            13'd1322: base_coeff <= 16'h0005;
            13'd1323: base_coeff <= 16'hffcf;
            13'd1324: base_coeff <= 16'h0049;
            13'd1325: base_coeff <= 16'hffb4;
            13'd1326: base_coeff <= 16'h0040;
            13'd1327: base_coeff <= 16'hffd7;
            13'd1328: base_coeff <= 16'h0011;
            13'd1329: base_coeff <= 16'h0004;
            13'd1330: base_coeff <= 16'hffed;
            13'd1331: base_coeff <= 16'h0019;
            13'd1332: base_coeff <= 16'hffe8;
            13'd1333: base_coeff <= 16'h0012;
            13'd1334: base_coeff <= 16'hfff5;
            13'd1335: base_coeff <= 16'h0004;
            13'd1336: base_coeff <= 16'h0002;
            13'd1337: base_coeff <= 16'hfffb;
            13'd1338: base_coeff <= 16'h0005;
            13'd1339: base_coeff <= 16'hfffc;
            13'd1340: base_coeff <= 16'h0003;
            13'd1341: base_coeff <= 16'hffff;
            13'd1342: base_coeff <= 16'h0000;
            13'd1343: base_coeff <= 16'h0000;
            13'd1344: base_coeff <= 16'h0001;
            13'd1345: base_coeff <= 16'hfffe;
            13'd1346: base_coeff <= 16'h0003;
            13'd1347: base_coeff <= 16'hfffc;
            13'd1348: base_coeff <= 16'h0003;
            13'd1349: base_coeff <= 16'hffff;
            13'd1350: base_coeff <= 16'hfffd;
            13'd1351: base_coeff <= 16'h0009;
            13'd1352: base_coeff <= 16'hfff2;
            13'd1353: base_coeff <= 16'h0013;
            13'd1354: base_coeff <= 16'hffed;
            13'd1355: base_coeff <= 16'h000e;
            13'd1356: base_coeff <= 16'hfffe;
            13'd1357: base_coeff <= 16'hfff1;
            13'd1358: base_coeff <= 16'h0023;
            13'd1359: base_coeff <= 16'hffcb;
            13'd1360: base_coeff <= 16'h0040;
            13'd1361: base_coeff <= 16'hffc4;
            13'd1362: base_coeff <= 16'h0027;
            13'd1363: base_coeff <= 16'hffff;
            13'd1364: base_coeff <= 16'hffce;
            13'd1365: base_coeff <= 16'h0068;
            13'd1366: base_coeff <= 16'hff6e;
            13'd1367: base_coeff <= 16'h00a4;
            13'd1368: base_coeff <= 16'hff6f;
            13'd1369: base_coeff <= 16'h0054;
            13'd1370: base_coeff <= 16'h000e;
            13'd1371: base_coeff <= 16'hff78;
            13'd1372: base_coeff <= 16'h00ff;
            13'd1373: base_coeff <= 16'hfeaa;
            13'd1374: base_coeff <= 16'h016f;
            13'd1375: base_coeff <= 16'hfecc;
            13'd1376: base_coeff <= 16'h009f;
            13'd1377: base_coeff <= 16'h0044;
            13'd1378: base_coeff <= 16'hfeaf;
            13'd1379: base_coeff <= 16'h0252;
            13'd1380: base_coeff <= 16'hfcf8;
            13'd1381: base_coeff <= 16'h0333;
            13'd1382: base_coeff <= 16'hfd61;
            13'd1383: base_coeff <= 16'h0135;
            13'd1384: base_coeff <= 16'h0101;
            13'd1385: base_coeff <= 16'hfc30;
            13'd1386: base_coeff <= 16'h06e0;
            13'd1387: base_coeff <= 16'hf64d;
            13'd1388: base_coeff <= 16'h0bac;
            13'd1389: base_coeff <= 16'hf425;
            13'd1390: base_coeff <= 16'h0779;
            13'd1391: base_coeff <= 16'h6c23;
            13'd1392: base_coeff <= 16'h1d72;
            13'd1393: base_coeff <= 16'hec66;
            13'd1394: base_coeff <= 16'h0dd3;
            13'd1395: base_coeff <= 16'hf724;
            13'd1396: base_coeff <= 16'h047e;
            13'd1397: base_coeff <= 16'hff1b;
            13'd1398: base_coeff <= 16'hfe45;
            13'd1399: base_coeff <= 16'h034b;
            13'd1400: base_coeff <= 16'hfc2b;
            13'd1401: base_coeff <= 16'h0383;
            13'd1402: base_coeff <= 16'hfd67;
            13'd1403: base_coeff <= 16'h0164;
            13'd1404: base_coeff <= 16'hffd3;
            13'd1405: base_coeff <= 16'hff2e;
            13'd1406: base_coeff <= 16'h0173;
            13'd1407: base_coeff <= 16'hfe55;
            13'd1408: base_coeff <= 16'h0184;
            13'd1409: base_coeff <= 16'hfee7;
            13'd1410: base_coeff <= 16'h008d;
            13'd1411: base_coeff <= 16'hfffe;
            13'd1412: base_coeff <= 16'hff93;
            13'd1413: base_coeff <= 16'h00af;
            13'd1414: base_coeff <= 16'hff40;
            13'd1415: base_coeff <= 16'h00a8;
            13'd1416: base_coeff <= 16'hff8c;
            13'd1417: base_coeff <= 16'h0034;
            13'd1418: base_coeff <= 16'h0007;
            13'd1419: base_coeff <= 16'hffcd;
            13'd1420: base_coeff <= 16'h004a;
            13'd1421: base_coeff <= 16'hffb3;
            13'd1422: base_coeff <= 16'h003f;
            13'd1423: base_coeff <= 16'hffd7;
            13'd1424: base_coeff <= 16'h0010;
            13'd1425: base_coeff <= 16'h0005;
            13'd1426: base_coeff <= 16'hffed;
            13'd1427: base_coeff <= 16'h0019;
            13'd1428: base_coeff <= 16'hffe8;
            13'd1429: base_coeff <= 16'h0012;
            13'd1430: base_coeff <= 16'hfff5;
            13'd1431: base_coeff <= 16'h0003;
            13'd1432: base_coeff <= 16'h0002;
            13'd1433: base_coeff <= 16'hfffb;
            13'd1434: base_coeff <= 16'h0005;
            13'd1435: base_coeff <= 16'hfffc;
            13'd1436: base_coeff <= 16'h0003;
            13'd1437: base_coeff <= 16'hffff;
            13'd1438: base_coeff <= 16'h0000;
            13'd1439: base_coeff <= 16'h0000;
            13'd1440: base_coeff <= 16'h0001;
            13'd1441: base_coeff <= 16'hfffe;
            13'd1442: base_coeff <= 16'h0003;
            13'd1443: base_coeff <= 16'hfffc;
            13'd1444: base_coeff <= 16'h0003;
            13'd1445: base_coeff <= 16'hffff;
            13'd1446: base_coeff <= 16'hfffd;
            13'd1447: base_coeff <= 16'h0009;
            13'd1448: base_coeff <= 16'hfff2;
            13'd1449: base_coeff <= 16'h0013;
            13'd1450: base_coeff <= 16'hffed;
            13'd1451: base_coeff <= 16'h000e;
            13'd1452: base_coeff <= 16'hfffe;
            13'd1453: base_coeff <= 16'hfff0;
            13'd1454: base_coeff <= 16'h0024;
            13'd1455: base_coeff <= 16'hffca;
            13'd1456: base_coeff <= 16'h003f;
            13'd1457: base_coeff <= 16'hffc5;
            13'd1458: base_coeff <= 16'h0026;
            13'd1459: base_coeff <= 16'h0001;
            13'd1460: base_coeff <= 16'hffcc;
            13'd1461: base_coeff <= 16'h0069;
            13'd1462: base_coeff <= 16'hff6d;
            13'd1463: base_coeff <= 16'h00a3;
            13'd1464: base_coeff <= 16'hff71;
            13'd1465: base_coeff <= 16'h0050;
            13'd1466: base_coeff <= 16'h0013;
            13'd1467: base_coeff <= 16'hff74;
            13'd1468: base_coeff <= 16'h0102;
            13'd1469: base_coeff <= 16'hfeaa;
            13'd1470: base_coeff <= 16'h016c;
            13'd1471: base_coeff <= 16'hfed2;
            13'd1472: base_coeff <= 16'h0096;
            13'd1473: base_coeff <= 16'h004d;
            13'd1474: base_coeff <= 16'hfea6;
            13'd1475: base_coeff <= 16'h0258;
            13'd1476: base_coeff <= 16'hfcf7;
            13'd1477: base_coeff <= 16'h032c;
            13'd1478: base_coeff <= 16'hfd6f;
            13'd1479: base_coeff <= 16'h0120;
            13'd1480: base_coeff <= 16'h0119;
            13'd1481: base_coeff <= 16'hfc19;
            13'd1482: base_coeff <= 16'h06ed;
            13'd1483: base_coeff <= 16'hf652;
            13'd1484: base_coeff <= 16'h0b8a;
            13'd1485: base_coeff <= 16'hf477;
            13'd1486: base_coeff <= 16'h06c4;
            13'd1487: base_coeff <= 16'h6bfb;
            13'd1488: base_coeff <= 16'h1e4a;
            13'd1489: base_coeff <= 16'hec2e;
            13'd1490: base_coeff <= 16'h0dd7;
            13'd1491: base_coeff <= 16'hf737;
            13'd1492: base_coeff <= 16'h0460;
            13'd1493: base_coeff <= 16'hff39;
            13'd1494: base_coeff <= 16'hfe2c;
            13'd1495: base_coeff <= 16'h035b;
            13'd1496: base_coeff <= 16'hfc24;
            13'd1497: base_coeff <= 16'h0382;
            13'd1498: base_coeff <= 16'hfd6e;
            13'd1499: base_coeff <= 16'h0159;
            13'd1500: base_coeff <= 16'hffdf;
            13'd1501: base_coeff <= 16'hff25;
            13'd1502: base_coeff <= 16'h0179;
            13'd1503: base_coeff <= 16'hfe53;
            13'd1504: base_coeff <= 16'h0183;
            13'd1505: base_coeff <= 16'hfeeb;
            13'd1506: base_coeff <= 16'h0088;
            13'd1507: base_coeff <= 16'h0003;
            13'd1508: base_coeff <= 16'hff8f;
            13'd1509: base_coeff <= 16'h00b1;
            13'd1510: base_coeff <= 16'hff3f;
            13'd1511: base_coeff <= 16'h00a7;
            13'd1512: base_coeff <= 16'hff8e;
            13'd1513: base_coeff <= 16'h0032;
            13'd1514: base_coeff <= 16'h0009;
            13'd1515: base_coeff <= 16'hffcb;
            13'd1516: base_coeff <= 16'h004b;
            13'd1517: base_coeff <= 16'hffb3;
            13'd1518: base_coeff <= 16'h003f;
            13'd1519: base_coeff <= 16'hffd8;
            13'd1520: base_coeff <= 16'h000f;
            13'd1521: base_coeff <= 16'h0006;
            13'd1522: base_coeff <= 16'hffec;
            13'd1523: base_coeff <= 16'h0019;
            13'd1524: base_coeff <= 16'hffe8;
            13'd1525: base_coeff <= 16'h0012;
            13'd1526: base_coeff <= 16'hfff6;
            13'd1527: base_coeff <= 16'h0003;
            13'd1528: base_coeff <= 16'h0002;
            13'd1529: base_coeff <= 16'hfffb;
            13'd1530: base_coeff <= 16'h0005;
            13'd1531: base_coeff <= 16'hfffc;
            13'd1532: base_coeff <= 16'h0003;
            13'd1533: base_coeff <= 16'hffff;
            13'd1534: base_coeff <= 16'h0000;
            13'd1535: base_coeff <= 16'h0000;
            13'd1536: base_coeff <= 16'h0001;
            13'd1537: base_coeff <= 16'hfffe;
            13'd1538: base_coeff <= 16'h0003;
            13'd1539: base_coeff <= 16'hfffc;
            13'd1540: base_coeff <= 16'h0003;
            13'd1541: base_coeff <= 16'hffff;
            13'd1542: base_coeff <= 16'hfffd;
            13'd1543: base_coeff <= 16'h0009;
            13'd1544: base_coeff <= 16'hfff1;
            13'd1545: base_coeff <= 16'h0013;
            13'd1546: base_coeff <= 16'hffed;
            13'd1547: base_coeff <= 16'h000d;
            13'd1548: base_coeff <= 16'hffff;
            13'd1549: base_coeff <= 16'hfff0;
            13'd1550: base_coeff <= 16'h0024;
            13'd1551: base_coeff <= 16'hffca;
            13'd1552: base_coeff <= 16'h003f;
            13'd1553: base_coeff <= 16'hffc6;
            13'd1554: base_coeff <= 16'h0024;
            13'd1555: base_coeff <= 16'h0003;
            13'd1556: base_coeff <= 16'hffca;
            13'd1557: base_coeff <= 16'h006a;
            13'd1558: base_coeff <= 16'hff6d;
            13'd1559: base_coeff <= 16'h00a2;
            13'd1560: base_coeff <= 16'hff74;
            13'd1561: base_coeff <= 16'h004d;
            13'd1562: base_coeff <= 16'h0017;
            13'd1563: base_coeff <= 16'hff70;
            13'd1564: base_coeff <= 16'h0104;
            13'd1565: base_coeff <= 16'hfea9;
            13'd1566: base_coeff <= 16'h016a;
            13'd1567: base_coeff <= 16'hfed8;
            13'd1568: base_coeff <= 16'h008e;
            13'd1569: base_coeff <= 16'h0057;
            13'd1570: base_coeff <= 16'hfe9e;
            13'd1571: base_coeff <= 16'h025e;
            13'd1572: base_coeff <= 16'hfcf8;
            13'd1573: base_coeff <= 16'h0325;
            13'd1574: base_coeff <= 16'hfd7e;
            13'd1575: base_coeff <= 16'h010b;
            13'd1576: base_coeff <= 16'h0131;
            13'd1577: base_coeff <= 16'hfc04;
            13'd1578: base_coeff <= 16'h06f9;
            13'd1579: base_coeff <= 16'hf657;
            13'd1580: base_coeff <= 16'h0b68;
            13'd1581: base_coeff <= 16'hf4c9;
            13'd1582: base_coeff <= 16'h0610;
            13'd1583: base_coeff <= 16'h6bc7;
            13'd1584: base_coeff <= 16'h1f22;
            13'd1585: base_coeff <= 16'hebf7;
            13'd1586: base_coeff <= 16'h0dda;
            13'd1587: base_coeff <= 16'hf74c;
            13'd1588: base_coeff <= 16'h0442;
            13'd1589: base_coeff <= 16'hff57;
            13'd1590: base_coeff <= 16'hfe13;
            13'd1591: base_coeff <= 16'h036b;
            13'd1592: base_coeff <= 16'hfc1e;
            13'd1593: base_coeff <= 16'h0380;
            13'd1594: base_coeff <= 16'hfd76;
            13'd1595: base_coeff <= 16'h014e;
            13'd1596: base_coeff <= 16'hffea;
            13'd1597: base_coeff <= 16'hff1b;
            13'd1598: base_coeff <= 16'h017f;
            13'd1599: base_coeff <= 16'hfe51;
            13'd1600: base_coeff <= 16'h0181;
            13'd1601: base_coeff <= 16'hfeef;
            13'd1602: base_coeff <= 16'h0083;
            13'd1603: base_coeff <= 16'h0008;
            13'd1604: base_coeff <= 16'hff8b;
            13'd1605: base_coeff <= 16'h00b4;
            13'd1606: base_coeff <= 16'hff3e;
            13'd1607: base_coeff <= 16'h00a6;
            13'd1608: base_coeff <= 16'hff90;
            13'd1609: base_coeff <= 16'h0030;
            13'd1610: base_coeff <= 16'h000b;
            13'd1611: base_coeff <= 16'hffca;
            13'd1612: base_coeff <= 16'h004c;
            13'd1613: base_coeff <= 16'hffb3;
            13'd1614: base_coeff <= 16'h003f;
            13'd1615: base_coeff <= 16'hffd9;
            13'd1616: base_coeff <= 16'h000e;
            13'd1617: base_coeff <= 16'h0007;
            13'd1618: base_coeff <= 16'hffec;
            13'd1619: base_coeff <= 16'h001a;
            13'd1620: base_coeff <= 16'hffe8;
            13'd1621: base_coeff <= 16'h0012;
            13'd1622: base_coeff <= 16'hfff6;
            13'd1623: base_coeff <= 16'h0003;
            13'd1624: base_coeff <= 16'h0002;
            13'd1625: base_coeff <= 16'hfffb;
            13'd1626: base_coeff <= 16'h0005;
            13'd1627: base_coeff <= 16'hfffc;
            13'd1628: base_coeff <= 16'h0003;
            13'd1629: base_coeff <= 16'hffff;
            13'd1630: base_coeff <= 16'h0000;
            13'd1631: base_coeff <= 16'h0000;
            13'd1632: base_coeff <= 16'h0001;
            13'd1633: base_coeff <= 16'hfffe;
            13'd1634: base_coeff <= 16'h0003;
            13'd1635: base_coeff <= 16'hfffd;
            13'd1636: base_coeff <= 16'h0003;
            13'd1637: base_coeff <= 16'hffff;
            13'd1638: base_coeff <= 16'hfffc;
            13'd1639: base_coeff <= 16'h0009;
            13'd1640: base_coeff <= 16'hfff1;
            13'd1641: base_coeff <= 16'h0012;
            13'd1642: base_coeff <= 16'hffee;
            13'd1643: base_coeff <= 16'h000d;
            13'd1644: base_coeff <= 16'hffff;
            13'd1645: base_coeff <= 16'hffef;
            13'd1646: base_coeff <= 16'h0025;
            13'd1647: base_coeff <= 16'hffca;
            13'd1648: base_coeff <= 16'h003f;
            13'd1649: base_coeff <= 16'hffc7;
            13'd1650: base_coeff <= 16'h0023;
            13'd1651: base_coeff <= 16'h0005;
            13'd1652: base_coeff <= 16'hffc8;
            13'd1653: base_coeff <= 16'h006c;
            13'd1654: base_coeff <= 16'hff6d;
            13'd1655: base_coeff <= 16'h00a1;
            13'd1656: base_coeff <= 16'hff76;
            13'd1657: base_coeff <= 16'h0049;
            13'd1658: base_coeff <= 16'h001c;
            13'd1659: base_coeff <= 16'hff6c;
            13'd1660: base_coeff <= 16'h0107;
            13'd1661: base_coeff <= 16'hfea9;
            13'd1662: base_coeff <= 16'h0167;
            13'd1663: base_coeff <= 16'hfede;
            13'd1664: base_coeff <= 16'h0085;
            13'd1665: base_coeff <= 16'h0061;
            13'd1666: base_coeff <= 16'hfe95;
            13'd1667: base_coeff <= 16'h0263;
            13'd1668: base_coeff <= 16'hfcf8;
            13'd1669: base_coeff <= 16'h031d;
            13'd1670: base_coeff <= 16'hfd8d;
            13'd1671: base_coeff <= 16'h00f6;
            13'd1672: base_coeff <= 16'h0149;
            13'd1673: base_coeff <= 16'hfbee;
            13'd1674: base_coeff <= 16'h0705;
            13'd1675: base_coeff <= 16'hf65d;
            13'd1676: base_coeff <= 16'h0b44;
            13'd1677: base_coeff <= 16'hf51b;
            13'd1678: base_coeff <= 16'h055e;
            13'd1679: base_coeff <= 16'h6b94;
            13'd1680: base_coeff <= 16'h1ffc;
            13'd1681: base_coeff <= 16'hebc1;
            13'd1682: base_coeff <= 16'h0ddc;
            13'd1683: base_coeff <= 16'hf762;
            13'd1684: base_coeff <= 16'h0424;
            13'd1685: base_coeff <= 16'hff76;
            13'd1686: base_coeff <= 16'hfdfb;
            13'd1687: base_coeff <= 16'h037b;
            13'd1688: base_coeff <= 16'hfc17;
            13'd1689: base_coeff <= 16'h037e;
            13'd1690: base_coeff <= 16'hfd7e;
            13'd1691: base_coeff <= 16'h0143;
            13'd1692: base_coeff <= 16'hfff5;
            13'd1693: base_coeff <= 16'hff12;
            13'd1694: base_coeff <= 16'h0185;
            13'd1695: base_coeff <= 16'hfe4f;
            13'd1696: base_coeff <= 16'h0180;
            13'd1697: base_coeff <= 16'hfef2;
            13'd1698: base_coeff <= 16'h007e;
            13'd1699: base_coeff <= 16'h000e;
            13'd1700: base_coeff <= 16'hff87;
            13'd1701: base_coeff <= 16'h00b6;
            13'd1702: base_coeff <= 16'hff3d;
            13'd1703: base_coeff <= 16'h00a6;
            13'd1704: base_coeff <= 16'hff92;
            13'd1705: base_coeff <= 16'h002e;
            13'd1706: base_coeff <= 16'h000d;
            13'd1707: base_coeff <= 16'hffc8;
            13'd1708: base_coeff <= 16'h004d;
            13'd1709: base_coeff <= 16'hffb3;
            13'd1710: base_coeff <= 16'h003e;
            13'd1711: base_coeff <= 16'hffd9;
            13'd1712: base_coeff <= 16'h000d;
            13'd1713: base_coeff <= 16'h0007;
            13'd1714: base_coeff <= 16'hffeb;
            13'd1715: base_coeff <= 16'h001a;
            13'd1716: base_coeff <= 16'hffe8;
            13'd1717: base_coeff <= 16'h0012;
            13'd1718: base_coeff <= 16'hfff6;
            13'd1719: base_coeff <= 16'h0003;
            13'd1720: base_coeff <= 16'h0002;
            13'd1721: base_coeff <= 16'hfffb;
            13'd1722: base_coeff <= 16'h0006;
            13'd1723: base_coeff <= 16'hfffc;
            13'd1724: base_coeff <= 16'h0003;
            13'd1725: base_coeff <= 16'hffff;
            13'd1726: base_coeff <= 16'h0000;
            13'd1727: base_coeff <= 16'h0000;
            13'd1728: base_coeff <= 16'h0001;
            13'd1729: base_coeff <= 16'hfffe;
            13'd1730: base_coeff <= 16'h0003;
            13'd1731: base_coeff <= 16'hfffd;
            13'd1732: base_coeff <= 16'h0003;
            13'd1733: base_coeff <= 16'h0000;
            13'd1734: base_coeff <= 16'hfffc;
            13'd1735: base_coeff <= 16'h0009;
            13'd1736: base_coeff <= 16'hfff1;
            13'd1737: base_coeff <= 16'h0012;
            13'd1738: base_coeff <= 16'hffee;
            13'd1739: base_coeff <= 16'h000c;
            13'd1740: base_coeff <= 16'h0000;
            13'd1741: base_coeff <= 16'hffee;
            13'd1742: base_coeff <= 16'h0025;
            13'd1743: base_coeff <= 16'hffca;
            13'd1744: base_coeff <= 16'h003e;
            13'd1745: base_coeff <= 16'hffc8;
            13'd1746: base_coeff <= 16'h0021;
            13'd1747: base_coeff <= 16'h0007;
            13'd1748: base_coeff <= 16'hffc7;
            13'd1749: base_coeff <= 16'h006d;
            13'd1750: base_coeff <= 16'hff6c;
            13'd1751: base_coeff <= 16'h00a0;
            13'd1752: base_coeff <= 16'hff79;
            13'd1753: base_coeff <= 16'h0045;
            13'd1754: base_coeff <= 16'h0020;
            13'd1755: base_coeff <= 16'hff68;
            13'd1756: base_coeff <= 16'h010a;
            13'd1757: base_coeff <= 16'hfea9;
            13'd1758: base_coeff <= 16'h0164;
            13'd1759: base_coeff <= 16'hfee4;
            13'd1760: base_coeff <= 16'h007d;
            13'd1761: base_coeff <= 16'h006b;
            13'd1762: base_coeff <= 16'hfe8c;
            13'd1763: base_coeff <= 16'h0268;
            13'd1764: base_coeff <= 16'hfcf8;
            13'd1765: base_coeff <= 16'h0315;
            13'd1766: base_coeff <= 16'hfd9c;
            13'd1767: base_coeff <= 16'h00e1;
            13'd1768: base_coeff <= 16'h0161;
            13'd1769: base_coeff <= 16'hfbd9;
            13'd1770: base_coeff <= 16'h0711;
            13'd1771: base_coeff <= 16'hf664;
            13'd1772: base_coeff <= 16'h0b20;
            13'd1773: base_coeff <= 16'hf56e;
            13'd1774: base_coeff <= 16'h04ae;
            13'd1775: base_coeff <= 16'h6b5c;
            13'd1776: base_coeff <= 16'h20d6;
            13'd1777: base_coeff <= 16'heb8d;
            13'd1778: base_coeff <= 16'h0ddc;
            13'd1779: base_coeff <= 16'hf778;
            13'd1780: base_coeff <= 16'h0405;
            13'd1781: base_coeff <= 16'hff94;
            13'd1782: base_coeff <= 16'hfde2;
            13'd1783: base_coeff <= 16'h038b;
            13'd1784: base_coeff <= 16'hfc11;
            13'd1785: base_coeff <= 16'h037c;
            13'd1786: base_coeff <= 16'hfd86;
            13'd1787: base_coeff <= 16'h0138;
            13'd1788: base_coeff <= 16'h0001;
            13'd1789: base_coeff <= 16'hff08;
            13'd1790: base_coeff <= 16'h018b;
            13'd1791: base_coeff <= 16'hfe4d;
            13'd1792: base_coeff <= 16'h017f;
            13'd1793: base_coeff <= 16'hfef6;
            13'd1794: base_coeff <= 16'h0078;
            13'd1795: base_coeff <= 16'h0013;
            13'd1796: base_coeff <= 16'hff83;
            13'd1797: base_coeff <= 16'h00b9;
            13'd1798: base_coeff <= 16'hff3d;
            13'd1799: base_coeff <= 16'h00a5;
            13'd1800: base_coeff <= 16'hff94;
            13'd1801: base_coeff <= 16'h002b;
            13'd1802: base_coeff <= 16'h0010;
            13'd1803: base_coeff <= 16'hffc7;
            13'd1804: base_coeff <= 16'h004e;
            13'd1805: base_coeff <= 16'hffb2;
            13'd1806: base_coeff <= 16'h003e;
            13'd1807: base_coeff <= 16'hffda;
            13'd1808: base_coeff <= 16'h000d;
            13'd1809: base_coeff <= 16'h0008;
            13'd1810: base_coeff <= 16'hffeb;
            13'd1811: base_coeff <= 16'h001a;
            13'd1812: base_coeff <= 16'hffe8;
            13'd1813: base_coeff <= 16'h0012;
            13'd1814: base_coeff <= 16'hfff6;
            13'd1815: base_coeff <= 16'h0002;
            13'd1816: base_coeff <= 16'h0003;
            13'd1817: base_coeff <= 16'hfffb;
            13'd1818: base_coeff <= 16'h0006;
            13'd1819: base_coeff <= 16'hfffc;
            13'd1820: base_coeff <= 16'h0003;
            13'd1821: base_coeff <= 16'hffff;
            13'd1822: base_coeff <= 16'h0000;
            13'd1823: base_coeff <= 16'h0000;
            13'd1824: base_coeff <= 16'h0001;
            13'd1825: base_coeff <= 16'hfffe;
            13'd1826: base_coeff <= 16'h0003;
            13'd1827: base_coeff <= 16'hfffd;
            13'd1828: base_coeff <= 16'h0003;
            13'd1829: base_coeff <= 16'h0000;
            13'd1830: base_coeff <= 16'hfffc;
            13'd1831: base_coeff <= 16'h0009;
            13'd1832: base_coeff <= 16'hfff1;
            13'd1833: base_coeff <= 16'h0012;
            13'd1834: base_coeff <= 16'hffee;
            13'd1835: base_coeff <= 16'h000c;
            13'd1836: base_coeff <= 16'h0001;
            13'd1837: base_coeff <= 16'hffee;
            13'd1838: base_coeff <= 16'h0026;
            13'd1839: base_coeff <= 16'hffca;
            13'd1840: base_coeff <= 16'h003e;
            13'd1841: base_coeff <= 16'hffc9;
            13'd1842: base_coeff <= 16'h0020;
            13'd1843: base_coeff <= 16'h0008;
            13'd1844: base_coeff <= 16'hffc5;
            13'd1845: base_coeff <= 16'h006e;
            13'd1846: base_coeff <= 16'hff6c;
            13'd1847: base_coeff <= 16'h009f;
            13'd1848: base_coeff <= 16'hff7c;
            13'd1849: base_coeff <= 16'h0041;
            13'd1850: base_coeff <= 16'h0024;
            13'd1851: base_coeff <= 16'hff64;
            13'd1852: base_coeff <= 16'h010c;
            13'd1853: base_coeff <= 16'hfea9;
            13'd1854: base_coeff <= 16'h0161;
            13'd1855: base_coeff <= 16'hfeea;
            13'd1856: base_coeff <= 16'h0074;
            13'd1857: base_coeff <= 16'h0074;
            13'd1858: base_coeff <= 16'hfe84;
            13'd1859: base_coeff <= 16'h026d;
            13'd1860: base_coeff <= 16'hfcf9;
            13'd1861: base_coeff <= 16'h030e;
            13'd1862: base_coeff <= 16'hfdab;
            13'd1863: base_coeff <= 16'h00cc;
            13'd1864: base_coeff <= 16'h0178;
            13'd1865: base_coeff <= 16'hfbc5;
            13'd1866: base_coeff <= 16'h071b;
            13'd1867: base_coeff <= 16'hf66b;
            13'd1868: base_coeff <= 16'h0afb;
            13'd1869: base_coeff <= 16'hf5c1;
            13'd1870: base_coeff <= 16'h0400;
            13'd1871: base_coeff <= 16'h6b24;
            13'd1872: base_coeff <= 16'h21b0;
            13'd1873: base_coeff <= 16'heb5a;
            13'd1874: base_coeff <= 16'h0ddc;
            13'd1875: base_coeff <= 16'hf78f;
            13'd1876: base_coeff <= 16'h03e6;
            13'd1877: base_coeff <= 16'hffb3;
            13'd1878: base_coeff <= 16'hfdca;
            13'd1879: base_coeff <= 16'h039a;
            13'd1880: base_coeff <= 16'hfc0c;
            13'd1881: base_coeff <= 16'h0379;
            13'd1882: base_coeff <= 16'hfd8f;
            13'd1883: base_coeff <= 16'h012c;
            13'd1884: base_coeff <= 16'h000c;
            13'd1885: base_coeff <= 16'hfeff;
            13'd1886: base_coeff <= 16'h0191;
            13'd1887: base_coeff <= 16'hfe4b;
            13'd1888: base_coeff <= 16'h017d;
            13'd1889: base_coeff <= 16'hfefb;
            13'd1890: base_coeff <= 16'h0073;
            13'd1891: base_coeff <= 16'h0018;
            13'd1892: base_coeff <= 16'hff7f;
            13'd1893: base_coeff <= 16'h00bb;
            13'd1894: base_coeff <= 16'hff3c;
            13'd1895: base_coeff <= 16'h00a4;
            13'd1896: base_coeff <= 16'hff95;
            13'd1897: base_coeff <= 16'h0029;
            13'd1898: base_coeff <= 16'h0012;
            13'd1899: base_coeff <= 16'hffc5;
            13'd1900: base_coeff <= 16'h004f;
            13'd1901: base_coeff <= 16'hffb2;
            13'd1902: base_coeff <= 16'h003d;
            13'd1903: base_coeff <= 16'hffdb;
            13'd1904: base_coeff <= 16'h000c;
            13'd1905: base_coeff <= 16'h0009;
            13'd1906: base_coeff <= 16'hffea;
            13'd1907: base_coeff <= 16'h001a;
            13'd1908: base_coeff <= 16'hffe8;
            13'd1909: base_coeff <= 16'h0012;
            13'd1910: base_coeff <= 16'hfff6;
            13'd1911: base_coeff <= 16'h0002;
            13'd1912: base_coeff <= 16'h0003;
            13'd1913: base_coeff <= 16'hfffb;
            13'd1914: base_coeff <= 16'h0006;
            13'd1915: base_coeff <= 16'hfffc;
            13'd1916: base_coeff <= 16'h0003;
            13'd1917: base_coeff <= 16'hffff;
            13'd1918: base_coeff <= 16'h0000;
            13'd1919: base_coeff <= 16'h0000;
            13'd1920: base_coeff <= 16'h0001;
            13'd1921: base_coeff <= 16'hfffe;
            13'd1922: base_coeff <= 16'h0003;
            13'd1923: base_coeff <= 16'hfffd;
            13'd1924: base_coeff <= 16'h0003;
            13'd1925: base_coeff <= 16'h0000;
            13'd1926: base_coeff <= 16'hfffc;
            13'd1927: base_coeff <= 16'h0009;
            13'd1928: base_coeff <= 16'hfff1;
            13'd1929: base_coeff <= 16'h0012;
            13'd1930: base_coeff <= 16'hffee;
            13'd1931: base_coeff <= 16'h000b;
            13'd1932: base_coeff <= 16'h0001;
            13'd1933: base_coeff <= 16'hffed;
            13'd1934: base_coeff <= 16'h0026;
            13'd1935: base_coeff <= 16'hffca;
            13'd1936: base_coeff <= 16'h003e;
            13'd1937: base_coeff <= 16'hffca;
            13'd1938: base_coeff <= 16'h001e;
            13'd1939: base_coeff <= 16'h000a;
            13'd1940: base_coeff <= 16'hffc3;
            13'd1941: base_coeff <= 16'h006f;
            13'd1942: base_coeff <= 16'hff6c;
            13'd1943: base_coeff <= 16'h009e;
            13'd1944: base_coeff <= 16'hff7e;
            13'd1945: base_coeff <= 16'h003d;
            13'd1946: base_coeff <= 16'h0029;
            13'd1947: base_coeff <= 16'hff60;
            13'd1948: base_coeff <= 16'h010f;
            13'd1949: base_coeff <= 16'hfea9;
            13'd1950: base_coeff <= 16'h015e;
            13'd1951: base_coeff <= 16'hfef0;
            13'd1952: base_coeff <= 16'h006b;
            13'd1953: base_coeff <= 16'h007e;
            13'd1954: base_coeff <= 16'hfe7c;
            13'd1955: base_coeff <= 16'h0272;
            13'd1956: base_coeff <= 16'hfcfa;
            13'd1957: base_coeff <= 16'h0305;
            13'd1958: base_coeff <= 16'hfdbb;
            13'd1959: base_coeff <= 16'h00b7;
            13'd1960: base_coeff <= 16'h018f;
            13'd1961: base_coeff <= 16'hfbb1;
            13'd1962: base_coeff <= 16'h0725;
            13'd1963: base_coeff <= 16'hf674;
            13'd1964: base_coeff <= 16'h0ad6;
            13'd1965: base_coeff <= 16'hf614;
            13'd1966: base_coeff <= 16'h0353;
            13'd1967: base_coeff <= 16'h6ae7;
            13'd1968: base_coeff <= 16'h228c;
            13'd1969: base_coeff <= 16'heb29;
            13'd1970: base_coeff <= 16'h0dda;
            13'd1971: base_coeff <= 16'hf7a7;
            13'd1972: base_coeff <= 16'h03c6;
            13'd1973: base_coeff <= 16'hffd1;
            13'd1974: base_coeff <= 16'hfdb2;
            13'd1975: base_coeff <= 16'h03a9;
            13'd1976: base_coeff <= 16'hfc06;
            13'd1977: base_coeff <= 16'h0376;
            13'd1978: base_coeff <= 16'hfd97;
            13'd1979: base_coeff <= 16'h0121;
            13'd1980: base_coeff <= 16'h0018;
            13'd1981: base_coeff <= 16'hfef6;
            13'd1982: base_coeff <= 16'h0196;
            13'd1983: base_coeff <= 16'hfe49;
            13'd1984: base_coeff <= 16'h017b;
            13'd1985: base_coeff <= 16'hfeff;
            13'd1986: base_coeff <= 16'h006e;
            13'd1987: base_coeff <= 16'h001d;
            13'd1988: base_coeff <= 16'hff7b;
            13'd1989: base_coeff <= 16'h00be;
            13'd1990: base_coeff <= 16'hff3c;
            13'd1991: base_coeff <= 16'h00a3;
            13'd1992: base_coeff <= 16'hff97;
            13'd1993: base_coeff <= 16'h0027;
            13'd1994: base_coeff <= 16'h0014;
            13'd1995: base_coeff <= 16'hffc3;
            13'd1996: base_coeff <= 16'h0050;
            13'd1997: base_coeff <= 16'hffb2;
            13'd1998: base_coeff <= 16'h003d;
            13'd1999: base_coeff <= 16'hffdc;
            13'd2000: base_coeff <= 16'h000b;
            13'd2001: base_coeff <= 16'h000a;
            13'd2002: base_coeff <= 16'hffea;
            13'd2003: base_coeff <= 16'h001b;
            13'd2004: base_coeff <= 16'hffe8;
            13'd2005: base_coeff <= 16'h0011;
            13'd2006: base_coeff <= 16'hfff7;
            13'd2007: base_coeff <= 16'h0002;
            13'd2008: base_coeff <= 16'h0003;
            13'd2009: base_coeff <= 16'hfffb;
            13'd2010: base_coeff <= 16'h0006;
            13'd2011: base_coeff <= 16'hfffc;
            13'd2012: base_coeff <= 16'h0003;
            13'd2013: base_coeff <= 16'hffff;
            13'd2014: base_coeff <= 16'h0000;
            13'd2015: base_coeff <= 16'h0000;
            13'd2016: base_coeff <= 16'h0001;
            13'd2017: base_coeff <= 16'hfffe;
            13'd2018: base_coeff <= 16'h0003;
            13'd2019: base_coeff <= 16'hfffd;
            13'd2020: base_coeff <= 16'h0003;
            13'd2021: base_coeff <= 16'h0000;
            13'd2022: base_coeff <= 16'hfffc;
            13'd2023: base_coeff <= 16'h000a;
            13'd2024: base_coeff <= 16'hfff1;
            13'd2025: base_coeff <= 16'h0012;
            13'd2026: base_coeff <= 16'hffef;
            13'd2027: base_coeff <= 16'h000b;
            13'd2028: base_coeff <= 16'h0002;
            13'd2029: base_coeff <= 16'hffed;
            13'd2030: base_coeff <= 16'h0027;
            13'd2031: base_coeff <= 16'hffc9;
            13'd2032: base_coeff <= 16'h003d;
            13'd2033: base_coeff <= 16'hffcb;
            13'd2034: base_coeff <= 16'h001d;
            13'd2035: base_coeff <= 16'h000c;
            13'd2036: base_coeff <= 16'hffc1;
            13'd2037: base_coeff <= 16'h0070;
            13'd2038: base_coeff <= 16'hff6c;
            13'd2039: base_coeff <= 16'h009c;
            13'd2040: base_coeff <= 16'hff81;
            13'd2041: base_coeff <= 16'h003a;
            13'd2042: base_coeff <= 16'h002d;
            13'd2043: base_coeff <= 16'hff5c;
            13'd2044: base_coeff <= 16'h0111;
            13'd2045: base_coeff <= 16'hfea9;
            13'd2046: base_coeff <= 16'h015a;
            13'd2047: base_coeff <= 16'hfef7;
            13'd2048: base_coeff <= 16'h0063;
            13'd2049: base_coeff <= 16'h0087;
            13'd2050: base_coeff <= 16'hfe73;
            13'd2051: base_coeff <= 16'h0276;
            13'd2052: base_coeff <= 16'hfcfc;
            13'd2053: base_coeff <= 16'h02fd;
            13'd2054: base_coeff <= 16'hfdca;
            13'd2055: base_coeff <= 16'h00a2;
            13'd2056: base_coeff <= 16'h01a6;
            13'd2057: base_coeff <= 16'hfb9d;
            13'd2058: base_coeff <= 16'h072f;
            13'd2059: base_coeff <= 16'hf67d;
            13'd2060: base_coeff <= 16'h0aaf;
            13'd2061: base_coeff <= 16'hf668;
            13'd2062: base_coeff <= 16'h02a9;
            13'd2063: base_coeff <= 16'h6aab;
            13'd2064: base_coeff <= 16'h2367;
            13'd2065: base_coeff <= 16'heaf9;
            13'd2066: base_coeff <= 16'h0dd7;
            13'd2067: base_coeff <= 16'hf7c0;
            13'd2068: base_coeff <= 16'h03a6;
            13'd2069: base_coeff <= 16'hfff0;
            13'd2070: base_coeff <= 16'hfd9a;
            13'd2071: base_coeff <= 16'h03b8;
            13'd2072: base_coeff <= 16'hfc01;
            13'd2073: base_coeff <= 16'h0373;
            13'd2074: base_coeff <= 16'hfda0;
            13'd2075: base_coeff <= 16'h0115;
            13'd2076: base_coeff <= 16'h0023;
            13'd2077: base_coeff <= 16'hfeed;
            13'd2078: base_coeff <= 16'h019c;
            13'd2079: base_coeff <= 16'hfe47;
            13'd2080: base_coeff <= 16'h0179;
            13'd2081: base_coeff <= 16'hff03;
            13'd2082: base_coeff <= 16'h0068;
            13'd2083: base_coeff <= 16'h0022;
            13'd2084: base_coeff <= 16'hff77;
            13'd2085: base_coeff <= 16'h00c0;
            13'd2086: base_coeff <= 16'hff3b;
            13'd2087: base_coeff <= 16'h00a2;
            13'd2088: base_coeff <= 16'hff99;
            13'd2089: base_coeff <= 16'h0024;
            13'd2090: base_coeff <= 16'h0016;
            13'd2091: base_coeff <= 16'hffc2;
            13'd2092: base_coeff <= 16'h0050;
            13'd2093: base_coeff <= 16'hffb2;
            13'd2094: base_coeff <= 16'h003d;
            13'd2095: base_coeff <= 16'hffdd;
            13'd2096: base_coeff <= 16'h000a;
            13'd2097: base_coeff <= 16'h000a;
            13'd2098: base_coeff <= 16'hffe9;
            13'd2099: base_coeff <= 16'h001b;
            13'd2100: base_coeff <= 16'hffe8;
            13'd2101: base_coeff <= 16'h0011;
            13'd2102: base_coeff <= 16'hfff7;
            13'd2103: base_coeff <= 16'h0002;
            13'd2104: base_coeff <= 16'h0003;
            13'd2105: base_coeff <= 16'hfffa;
            13'd2106: base_coeff <= 16'h0006;
            13'd2107: base_coeff <= 16'hfffc;
            13'd2108: base_coeff <= 16'h0003;
            13'd2109: base_coeff <= 16'hffff;
            13'd2110: base_coeff <= 16'h0000;
            13'd2111: base_coeff <= 16'h0000;
            13'd2112: base_coeff <= 16'h0001;
            13'd2113: base_coeff <= 16'hfffe;
            13'd2114: base_coeff <= 16'h0003;
            13'd2115: base_coeff <= 16'hfffd;
            13'd2116: base_coeff <= 16'h0002;
            13'd2117: base_coeff <= 16'h0000;
            13'd2118: base_coeff <= 16'hfffc;
            13'd2119: base_coeff <= 16'h000a;
            13'd2120: base_coeff <= 16'hfff1;
            13'd2121: base_coeff <= 16'h0012;
            13'd2122: base_coeff <= 16'hffef;
            13'd2123: base_coeff <= 16'h000a;
            13'd2124: base_coeff <= 16'h0002;
            13'd2125: base_coeff <= 16'hffec;
            13'd2126: base_coeff <= 16'h0027;
            13'd2127: base_coeff <= 16'hffc9;
            13'd2128: base_coeff <= 16'h003d;
            13'd2129: base_coeff <= 16'hffcc;
            13'd2130: base_coeff <= 16'h001b;
            13'd2131: base_coeff <= 16'h000e;
            13'd2132: base_coeff <= 16'hffc0;
            13'd2133: base_coeff <= 16'h0071;
            13'd2134: base_coeff <= 16'hff6c;
            13'd2135: base_coeff <= 16'h009b;
            13'd2136: base_coeff <= 16'hff84;
            13'd2137: base_coeff <= 16'h0036;
            13'd2138: base_coeff <= 16'h0031;
            13'd2139: base_coeff <= 16'hff58;
            13'd2140: base_coeff <= 16'h0113;
            13'd2141: base_coeff <= 16'hfea9;
            13'd2142: base_coeff <= 16'h0157;
            13'd2143: base_coeff <= 16'hfefd;
            13'd2144: base_coeff <= 16'h005a;
            13'd2145: base_coeff <= 16'h0091;
            13'd2146: base_coeff <= 16'hfe6b;
            13'd2147: base_coeff <= 16'h027a;
            13'd2148: base_coeff <= 16'hfcfd;
            13'd2149: base_coeff <= 16'h02f4;
            13'd2150: base_coeff <= 16'hfdda;
            13'd2151: base_coeff <= 16'h008d;
            13'd2152: base_coeff <= 16'h01bd;
            13'd2153: base_coeff <= 16'hfb8a;
            13'd2154: base_coeff <= 16'h0738;
            13'd2155: base_coeff <= 16'hf687;
            13'd2156: base_coeff <= 16'h0a88;
            13'd2157: base_coeff <= 16'hf6bc;
            13'd2158: base_coeff <= 16'h0200;
            13'd2159: base_coeff <= 16'h6a6a;
            13'd2160: base_coeff <= 16'h2444;
            13'd2161: base_coeff <= 16'heacb;
            13'd2162: base_coeff <= 16'h0dd3;
            13'd2163: base_coeff <= 16'hf7d9;
            13'd2164: base_coeff <= 16'h0385;
            13'd2165: base_coeff <= 16'h000f;
            13'd2166: base_coeff <= 16'hfd82;
            13'd2167: base_coeff <= 16'h03c6;
            13'd2168: base_coeff <= 16'hfbfd;
            13'd2169: base_coeff <= 16'h0370;
            13'd2170: base_coeff <= 16'hfda9;
            13'd2171: base_coeff <= 16'h010a;
            13'd2172: base_coeff <= 16'h002f;
            13'd2173: base_coeff <= 16'hfee4;
            13'd2174: base_coeff <= 16'h01a1;
            13'd2175: base_coeff <= 16'hfe46;
            13'd2176: base_coeff <= 16'h0177;
            13'd2177: base_coeff <= 16'hff07;
            13'd2178: base_coeff <= 16'h0063;
            13'd2179: base_coeff <= 16'h0027;
            13'd2180: base_coeff <= 16'hff73;
            13'd2181: base_coeff <= 16'h00c2;
            13'd2182: base_coeff <= 16'hff3b;
            13'd2183: base_coeff <= 16'h00a1;
            13'd2184: base_coeff <= 16'hff9b;
            13'd2185: base_coeff <= 16'h0022;
            13'd2186: base_coeff <= 16'h0018;
            13'd2187: base_coeff <= 16'hffc0;
            13'd2188: base_coeff <= 16'h0051;
            13'd2189: base_coeff <= 16'hffb2;
            13'd2190: base_coeff <= 16'h003c;
            13'd2191: base_coeff <= 16'hffdd;
            13'd2192: base_coeff <= 16'h0009;
            13'd2193: base_coeff <= 16'h000b;
            13'd2194: base_coeff <= 16'hffe9;
            13'd2195: base_coeff <= 16'h001b;
            13'd2196: base_coeff <= 16'hffe8;
            13'd2197: base_coeff <= 16'h0011;
            13'd2198: base_coeff <= 16'hfff7;
            13'd2199: base_coeff <= 16'h0002;
            13'd2200: base_coeff <= 16'h0003;
            13'd2201: base_coeff <= 16'hfffa;
            13'd2202: base_coeff <= 16'h0006;
            13'd2203: base_coeff <= 16'hfffc;
            13'd2204: base_coeff <= 16'h0003;
            13'd2205: base_coeff <= 16'hffff;
            13'd2206: base_coeff <= 16'h0000;
            13'd2207: base_coeff <= 16'h0000;
            13'd2208: base_coeff <= 16'h0001;
            13'd2209: base_coeff <= 16'hfffe;
            13'd2210: base_coeff <= 16'h0003;
            13'd2211: base_coeff <= 16'hfffd;
            13'd2212: base_coeff <= 16'h0002;
            13'd2213: base_coeff <= 16'h0000;
            13'd2214: base_coeff <= 16'hfffc;
            13'd2215: base_coeff <= 16'h000a;
            13'd2216: base_coeff <= 16'hfff1;
            13'd2217: base_coeff <= 16'h0012;
            13'd2218: base_coeff <= 16'hffef;
            13'd2219: base_coeff <= 16'h000a;
            13'd2220: base_coeff <= 16'h0003;
            13'd2221: base_coeff <= 16'hffeb;
            13'd2222: base_coeff <= 16'h0028;
            13'd2223: base_coeff <= 16'hffc9;
            13'd2224: base_coeff <= 16'h003c;
            13'd2225: base_coeff <= 16'hffcd;
            13'd2226: base_coeff <= 16'h001a;
            13'd2227: base_coeff <= 16'h0010;
            13'd2228: base_coeff <= 16'hffbe;
            13'd2229: base_coeff <= 16'h0072;
            13'd2230: base_coeff <= 16'hff6c;
            13'd2231: base_coeff <= 16'h009a;
            13'd2232: base_coeff <= 16'hff86;
            13'd2233: base_coeff <= 16'h0032;
            13'd2234: base_coeff <= 16'h0036;
            13'd2235: base_coeff <= 16'hff55;
            13'd2236: base_coeff <= 16'h0116;
            13'd2237: base_coeff <= 16'hfeaa;
            13'd2238: base_coeff <= 16'h0154;
            13'd2239: base_coeff <= 16'hff04;
            13'd2240: base_coeff <= 16'h0051;
            13'd2241: base_coeff <= 16'h009a;
            13'd2242: base_coeff <= 16'hfe63;
            13'd2243: base_coeff <= 16'h027e;
            13'd2244: base_coeff <= 16'hfcff;
            13'd2245: base_coeff <= 16'h02eb;
            13'd2246: base_coeff <= 16'hfdea;
            13'd2247: base_coeff <= 16'h0078;
            13'd2248: base_coeff <= 16'h01d4;
            13'd2249: base_coeff <= 16'hfb77;
            13'd2250: base_coeff <= 16'h0740;
            13'd2251: base_coeff <= 16'hf692;
            13'd2252: base_coeff <= 16'h0a60;
            13'd2253: base_coeff <= 16'hf710;
            13'd2254: base_coeff <= 16'h0159;
            13'd2255: base_coeff <= 16'h6a22;
            13'd2256: base_coeff <= 16'h2520;
            13'd2257: base_coeff <= 16'hea9e;
            13'd2258: base_coeff <= 16'h0dcd;
            13'd2259: base_coeff <= 16'hf7f3;
            13'd2260: base_coeff <= 16'h0364;
            13'd2261: base_coeff <= 16'h002e;
            13'd2262: base_coeff <= 16'hfd6a;
            13'd2263: base_coeff <= 16'h03d4;
            13'd2264: base_coeff <= 16'hfbf8;
            13'd2265: base_coeff <= 16'h036c;
            13'd2266: base_coeff <= 16'hfdb3;
            13'd2267: base_coeff <= 16'h00fe;
            13'd2268: base_coeff <= 16'h003a;
            13'd2269: base_coeff <= 16'hfedb;
            13'd2270: base_coeff <= 16'h01a7;
            13'd2271: base_coeff <= 16'hfe45;
            13'd2272: base_coeff <= 16'h0175;
            13'd2273: base_coeff <= 16'hff0c;
            13'd2274: base_coeff <= 16'h005e;
            13'd2275: base_coeff <= 16'h002c;
            13'd2276: base_coeff <= 16'hff6f;
            13'd2277: base_coeff <= 16'h00c4;
            13'd2278: base_coeff <= 16'hff3a;
            13'd2279: base_coeff <= 16'h00a0;
            13'd2280: base_coeff <= 16'hff9d;
            13'd2281: base_coeff <= 16'h0020;
            13'd2282: base_coeff <= 16'h001a;
            13'd2283: base_coeff <= 16'hffbf;
            13'd2284: base_coeff <= 16'h0052;
            13'd2285: base_coeff <= 16'hffb2;
            13'd2286: base_coeff <= 16'h003c;
            13'd2287: base_coeff <= 16'hffde;
            13'd2288: base_coeff <= 16'h0008;
            13'd2289: base_coeff <= 16'h000c;
            13'd2290: base_coeff <= 16'hffe8;
            13'd2291: base_coeff <= 16'h001b;
            13'd2292: base_coeff <= 16'hffe8;
            13'd2293: base_coeff <= 16'h0011;
            13'd2294: base_coeff <= 16'hfff7;
            13'd2295: base_coeff <= 16'h0001;
            13'd2296: base_coeff <= 16'h0004;
            13'd2297: base_coeff <= 16'hfffa;
            13'd2298: base_coeff <= 16'h0006;
            13'd2299: base_coeff <= 16'hfffc;
            13'd2300: base_coeff <= 16'h0003;
            13'd2301: base_coeff <= 16'hffff;
            13'd2302: base_coeff <= 16'h0000;
            13'd2303: base_coeff <= 16'h0000;
            13'd2304: base_coeff <= 16'h0001;
            13'd2305: base_coeff <= 16'hfffe;
            13'd2306: base_coeff <= 16'h0003;
            13'd2307: base_coeff <= 16'hfffd;
            13'd2308: base_coeff <= 16'h0002;
            13'd2309: base_coeff <= 16'h0000;
            13'd2310: base_coeff <= 16'hfffb;
            13'd2311: base_coeff <= 16'h000a;
            13'd2312: base_coeff <= 16'hfff1;
            13'd2313: base_coeff <= 16'h0012;
            13'd2314: base_coeff <= 16'hfff0;
            13'd2315: base_coeff <= 16'h0009;
            13'd2316: base_coeff <= 16'h0004;
            13'd2317: base_coeff <= 16'hffeb;
            13'd2318: base_coeff <= 16'h0028;
            13'd2319: base_coeff <= 16'hffc9;
            13'd2320: base_coeff <= 16'h003c;
            13'd2321: base_coeff <= 16'hffce;
            13'd2322: base_coeff <= 16'h0018;
            13'd2323: base_coeff <= 16'h0011;
            13'd2324: base_coeff <= 16'hffbd;
            13'd2325: base_coeff <= 16'h0073;
            13'd2326: base_coeff <= 16'hff6c;
            13'd2327: base_coeff <= 16'h0098;
            13'd2328: base_coeff <= 16'hff89;
            13'd2329: base_coeff <= 16'h002e;
            13'd2330: base_coeff <= 16'h003a;
            13'd2331: base_coeff <= 16'hff51;
            13'd2332: base_coeff <= 16'h0118;
            13'd2333: base_coeff <= 16'hfeaa;
            13'd2334: base_coeff <= 16'h0150;
            13'd2335: base_coeff <= 16'hff0a;
            13'd2336: base_coeff <= 16'h0048;
            13'd2337: base_coeff <= 16'h00a3;
            13'd2338: base_coeff <= 16'hfe5c;
            13'd2339: base_coeff <= 16'h0282;
            13'd2340: base_coeff <= 16'hfd01;
            13'd2341: base_coeff <= 16'h02e2;
            13'd2342: base_coeff <= 16'hfdfa;
            13'd2343: base_coeff <= 16'h0063;
            13'd2344: base_coeff <= 16'h01ea;
            13'd2345: base_coeff <= 16'hfb64;
            13'd2346: base_coeff <= 16'h0747;
            13'd2347: base_coeff <= 16'hf69e;
            13'd2348: base_coeff <= 16'h0a38;
            13'd2349: base_coeff <= 16'hf765;
            13'd2350: base_coeff <= 16'h00b3;
            13'd2351: base_coeff <= 16'h69db;
            13'd2352: base_coeff <= 16'h25fd;
            13'd2353: base_coeff <= 16'hea72;
            13'd2354: base_coeff <= 16'h0dc7;
            13'd2355: base_coeff <= 16'hf80f;
            13'd2356: base_coeff <= 16'h0343;
            13'd2357: base_coeff <= 16'h004d;
            13'd2358: base_coeff <= 16'hfd52;
            13'd2359: base_coeff <= 16'h03e2;
            13'd2360: base_coeff <= 16'hfbf4;
            13'd2361: base_coeff <= 16'h0368;
            13'd2362: base_coeff <= 16'hfdbc;
            13'd2363: base_coeff <= 16'h00f2;
            13'd2364: base_coeff <= 16'h0046;
            13'd2365: base_coeff <= 16'hfed2;
            13'd2366: base_coeff <= 16'h01ac;
            13'd2367: base_coeff <= 16'hfe44;
            13'd2368: base_coeff <= 16'h0173;
            13'd2369: base_coeff <= 16'hff10;
            13'd2370: base_coeff <= 16'h0058;
            13'd2371: base_coeff <= 16'h0032;
            13'd2372: base_coeff <= 16'hff6b;
            13'd2373: base_coeff <= 16'h00c6;
            13'd2374: base_coeff <= 16'hff3a;
            13'd2375: base_coeff <= 16'h009e;
            13'd2376: base_coeff <= 16'hffa0;
            13'd2377: base_coeff <= 16'h001d;
            13'd2378: base_coeff <= 16'h001c;
            13'd2379: base_coeff <= 16'hffbd;
            13'd2380: base_coeff <= 16'h0053;
            13'd2381: base_coeff <= 16'hffb2;
            13'd2382: base_coeff <= 16'h003b;
            13'd2383: base_coeff <= 16'hffdf;
            13'd2384: base_coeff <= 16'h0007;
            13'd2385: base_coeff <= 16'h000d;
            13'd2386: base_coeff <= 16'hffe8;
            13'd2387: base_coeff <= 16'h001c;
            13'd2388: base_coeff <= 16'hffe8;
            13'd2389: base_coeff <= 16'h0011;
            13'd2390: base_coeff <= 16'hfff8;
            13'd2391: base_coeff <= 16'h0001;
            13'd2392: base_coeff <= 16'h0004;
            13'd2393: base_coeff <= 16'hfffa;
            13'd2394: base_coeff <= 16'h0006;
            13'd2395: base_coeff <= 16'hfffc;
            13'd2396: base_coeff <= 16'h0003;
            13'd2397: base_coeff <= 16'hffff;
            13'd2398: base_coeff <= 16'h0000;
            13'd2399: base_coeff <= 16'h0000;
            13'd2400: base_coeff <= 16'h0001;
            13'd2401: base_coeff <= 16'hfffe;
            13'd2402: base_coeff <= 16'h0003;
            13'd2403: base_coeff <= 16'hfffd;
            13'd2404: base_coeff <= 16'h0002;
            13'd2405: base_coeff <= 16'h0000;
            13'd2406: base_coeff <= 16'hfffb;
            13'd2407: base_coeff <= 16'h000a;
            13'd2408: base_coeff <= 16'hfff1;
            13'd2409: base_coeff <= 16'h0012;
            13'd2410: base_coeff <= 16'hfff0;
            13'd2411: base_coeff <= 16'h0009;
            13'd2412: base_coeff <= 16'h0004;
            13'd2413: base_coeff <= 16'hffea;
            13'd2414: base_coeff <= 16'h0028;
            13'd2415: base_coeff <= 16'hffc9;
            13'd2416: base_coeff <= 16'h003b;
            13'd2417: base_coeff <= 16'hffcf;
            13'd2418: base_coeff <= 16'h0016;
            13'd2419: base_coeff <= 16'h0013;
            13'd2420: base_coeff <= 16'hffbb;
            13'd2421: base_coeff <= 16'h0074;
            13'd2422: base_coeff <= 16'hff6c;
            13'd2423: base_coeff <= 16'h0097;
            13'd2424: base_coeff <= 16'hff8c;
            13'd2425: base_coeff <= 16'h002a;
            13'd2426: base_coeff <= 16'h003e;
            13'd2427: base_coeff <= 16'hff4d;
            13'd2428: base_coeff <= 16'h011a;
            13'd2429: base_coeff <= 16'hfeab;
            13'd2430: base_coeff <= 16'h014c;
            13'd2431: base_coeff <= 16'hff11;
            13'd2432: base_coeff <= 16'h0040;
            13'd2433: base_coeff <= 16'h00ad;
            13'd2434: base_coeff <= 16'hfe54;
            13'd2435: base_coeff <= 16'h0286;
            13'd2436: base_coeff <= 16'hfd03;
            13'd2437: base_coeff <= 16'h02d9;
            13'd2438: base_coeff <= 16'hfe0a;
            13'd2439: base_coeff <= 16'h004d;
            13'd2440: base_coeff <= 16'h0201;
            13'd2441: base_coeff <= 16'hfb52;
            13'd2442: base_coeff <= 16'h074e;
            13'd2443: base_coeff <= 16'hf6aa;
            13'd2444: base_coeff <= 16'h0a0e;
            13'd2445: base_coeff <= 16'hf7ba;
            13'd2446: base_coeff <= 16'h0010;
            13'd2447: base_coeff <= 16'h6992;
            13'd2448: base_coeff <= 16'h26da;
            13'd2449: base_coeff <= 16'hea48;
            13'd2450: base_coeff <= 16'h0dbf;
            13'd2451: base_coeff <= 16'hf82a;
            13'd2452: base_coeff <= 16'h0321;
            13'd2453: base_coeff <= 16'h006c;
            13'd2454: base_coeff <= 16'hfd3b;
            13'd2455: base_coeff <= 16'h03f0;
            13'd2456: base_coeff <= 16'hfbf1;
            13'd2457: base_coeff <= 16'h0363;
            13'd2458: base_coeff <= 16'hfdc6;
            13'd2459: base_coeff <= 16'h00e6;
            13'd2460: base_coeff <= 16'h0051;
            13'd2461: base_coeff <= 16'hfec9;
            13'd2462: base_coeff <= 16'h01b1;
            13'd2463: base_coeff <= 16'hfe43;
            13'd2464: base_coeff <= 16'h0170;
            13'd2465: base_coeff <= 16'hff15;
            13'd2466: base_coeff <= 16'h0053;
            13'd2467: base_coeff <= 16'h0037;
            13'd2468: base_coeff <= 16'hff67;
            13'd2469: base_coeff <= 16'h00c8;
            13'd2470: base_coeff <= 16'hff3a;
            13'd2471: base_coeff <= 16'h009d;
            13'd2472: base_coeff <= 16'hffa2;
            13'd2473: base_coeff <= 16'h001b;
            13'd2474: base_coeff <= 16'h001f;
            13'd2475: base_coeff <= 16'hffbc;
            13'd2476: base_coeff <= 16'h0053;
            13'd2477: base_coeff <= 16'hffb2;
            13'd2478: base_coeff <= 16'h003a;
            13'd2479: base_coeff <= 16'hffe0;
            13'd2480: base_coeff <= 16'h0007;
            13'd2481: base_coeff <= 16'h000d;
            13'd2482: base_coeff <= 16'hffe7;
            13'd2483: base_coeff <= 16'h001c;
            13'd2484: base_coeff <= 16'hffe8;
            13'd2485: base_coeff <= 16'h0011;
            13'd2486: base_coeff <= 16'hfff8;
            13'd2487: base_coeff <= 16'h0001;
            13'd2488: base_coeff <= 16'h0004;
            13'd2489: base_coeff <= 16'hfffa;
            13'd2490: base_coeff <= 16'h0006;
            13'd2491: base_coeff <= 16'hfffc;
            13'd2492: base_coeff <= 16'h0003;
            13'd2493: base_coeff <= 16'hffff;
            13'd2494: base_coeff <= 16'h0000;
            13'd2495: base_coeff <= 16'h0000;
            13'd2496: base_coeff <= 16'h0001;
            13'd2497: base_coeff <= 16'hfffe;
            13'd2498: base_coeff <= 16'h0003;
            13'd2499: base_coeff <= 16'hfffd;
            13'd2500: base_coeff <= 16'h0002;
            13'd2501: base_coeff <= 16'h0001;
            13'd2502: base_coeff <= 16'hfffb;
            13'd2503: base_coeff <= 16'h000a;
            13'd2504: base_coeff <= 16'hfff1;
            13'd2505: base_coeff <= 16'h0011;
            13'd2506: base_coeff <= 16'hfff0;
            13'd2507: base_coeff <= 16'h0008;
            13'd2508: base_coeff <= 16'h0005;
            13'd2509: base_coeff <= 16'hffea;
            13'd2510: base_coeff <= 16'h0029;
            13'd2511: base_coeff <= 16'hffc9;
            13'd2512: base_coeff <= 16'h003b;
            13'd2513: base_coeff <= 16'hffd0;
            13'd2514: base_coeff <= 16'h0015;
            13'd2515: base_coeff <= 16'h0015;
            13'd2516: base_coeff <= 16'hffb9;
            13'd2517: base_coeff <= 16'h0075;
            13'd2518: base_coeff <= 16'hff6c;
            13'd2519: base_coeff <= 16'h0095;
            13'd2520: base_coeff <= 16'hff8f;
            13'd2521: base_coeff <= 16'h0026;
            13'd2522: base_coeff <= 16'h0042;
            13'd2523: base_coeff <= 16'hff4a;
            13'd2524: base_coeff <= 16'h011b;
            13'd2525: base_coeff <= 16'hfeab;
            13'd2526: base_coeff <= 16'h0148;
            13'd2527: base_coeff <= 16'hff18;
            13'd2528: base_coeff <= 16'h0037;
            13'd2529: base_coeff <= 16'h00b6;
            13'd2530: base_coeff <= 16'hfe4d;
            13'd2531: base_coeff <= 16'h0289;
            13'd2532: base_coeff <= 16'hfd06;
            13'd2533: base_coeff <= 16'h02cf;
            13'd2534: base_coeff <= 16'hfe1b;
            13'd2535: base_coeff <= 16'h0038;
            13'd2536: base_coeff <= 16'h0217;
            13'd2537: base_coeff <= 16'hfb41;
            13'd2538: base_coeff <= 16'h0754;
            13'd2539: base_coeff <= 16'hf6b7;
            13'd2540: base_coeff <= 16'h09e4;
            13'd2541: base_coeff <= 16'hf80f;
            13'd2542: base_coeff <= 16'hff6e;
            13'd2543: base_coeff <= 16'h6943;
            13'd2544: base_coeff <= 16'h27b8;
            13'd2545: base_coeff <= 16'hea20;
            13'd2546: base_coeff <= 16'h0db6;
            13'd2547: base_coeff <= 16'hf847;
            13'd2548: base_coeff <= 16'h02ff;
            13'd2549: base_coeff <= 16'h008b;
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
